dkomeza/peak/README.md

# peak
A small e-bike display meant for VESC
