dkomeza/peak/hardware/peak.step

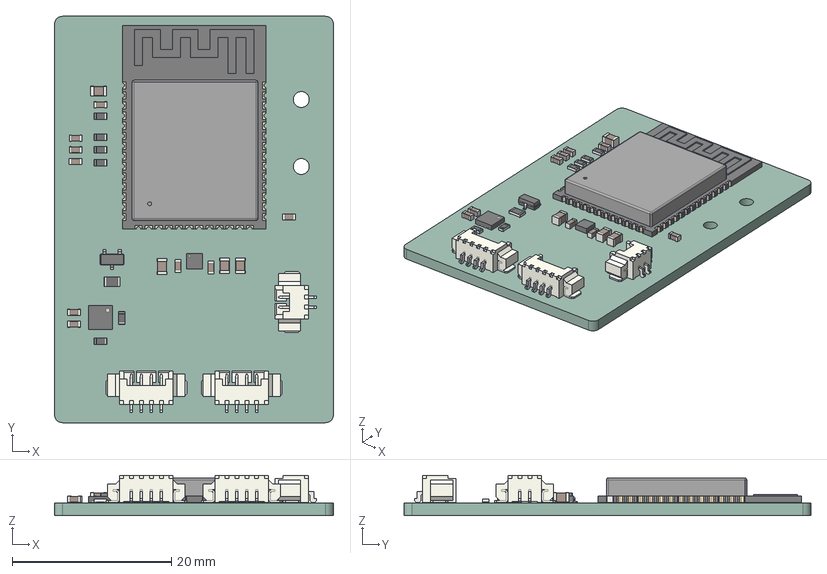
[picture p1: CAD file, 2025-06-28]
hardware/peak.step
35.0 x 51.0 x 5.05 mm
C_0603_1608Metric x 9
C_0805_2012Metric x 4
Molex_53261_0471 x 2
R_0805_2012Metric
R_0603_1608Metric x 6
SOT_23
Molex_53261_0271
ESP32-S3-WROOM-1
DFN-8-1EP_3x3mm_Pitch0.65mm
WSON_6_1EP_2x2mm_P065mm_EP1x16mm
peak_PCB
