dkomeza/peak/hardware/utils/peak-PasteTop.dxf

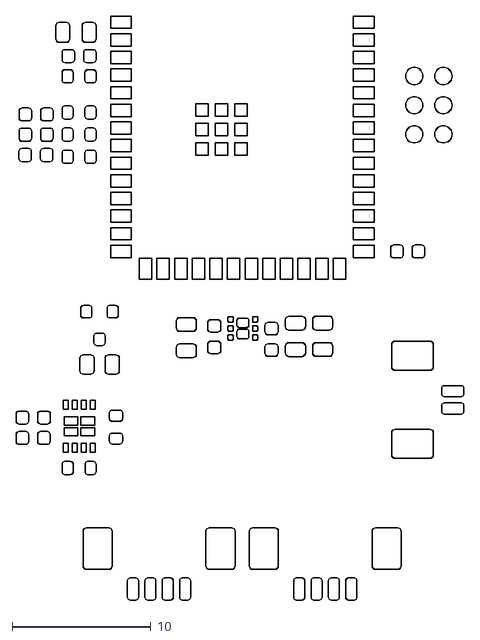
[picture p2: CAD file, 2025-04-22]
hardware/utils/peak-PasteTop.dxf
32.3 x 42.1
