dkomeza/peak/hardware/utils/peak-EdgeCuts.dxf

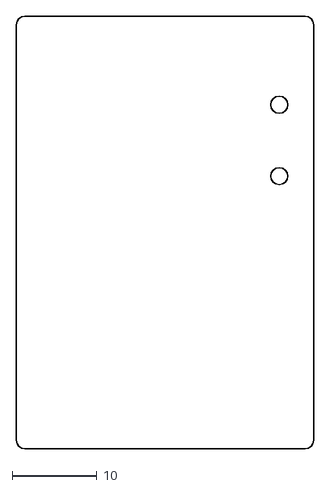
[picture p3: CAD file, 2025-04-22]
hardware/utils/peak-EdgeCuts.dxf
35.0 x 51.0
