dkomeza/peak/hardware/utils/bottomStencil.stl

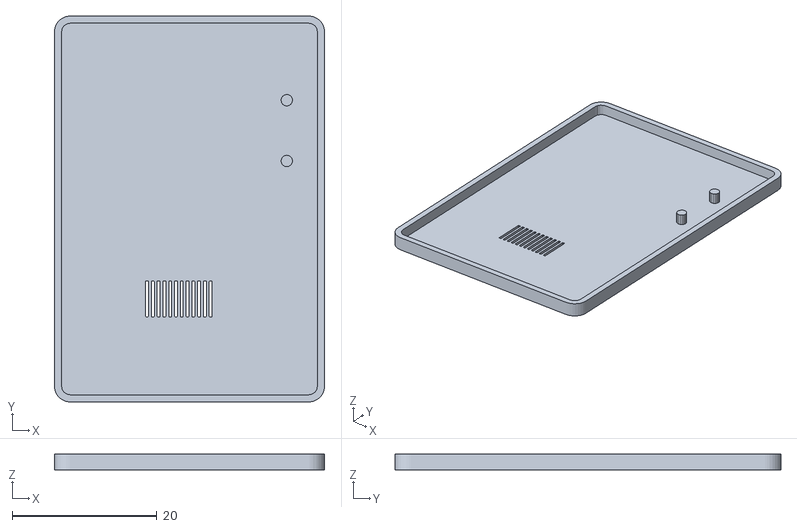
[picture p4: CAD file, 2025-04-22]
hardware/utils/bottomStencil.stl
37.4 x 53.4 x 2.20
