dkomeza/peak/hardware/utils/peak-PasteBottom.dxf

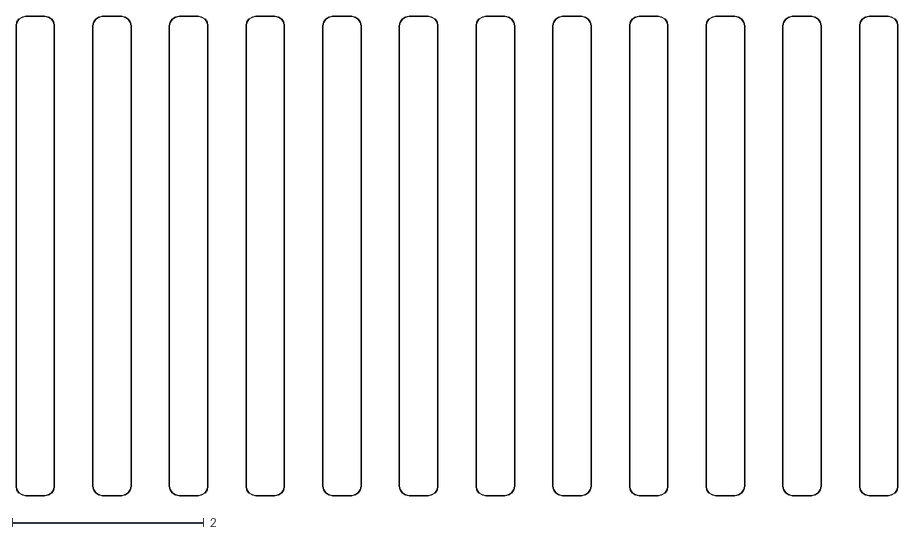
[picture p5: CAD file, 2025-04-22]
hardware/utils/peak-PasteBottom.dxf
9.20 x 5.00
