dkomeza/peak/hardware/utils/topStencil.stl

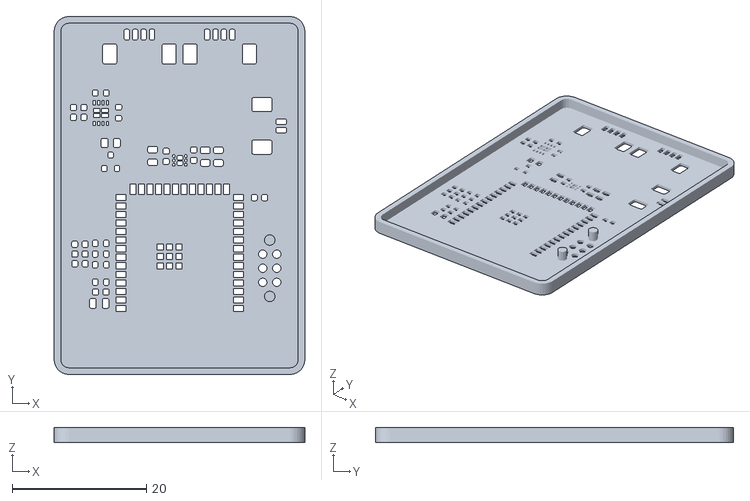
[picture p6: CAD file, 2025-04-22]
hardware/utils/topStencil.stl
37.4 x 53.4 x 2.20
