dkomeza/peak/(list of files, cad)

Other CAD files:
hardware/utils/topStencil.scad
hardware/peak.3mf
