dkomeza/peak/hardware/peak.pdf

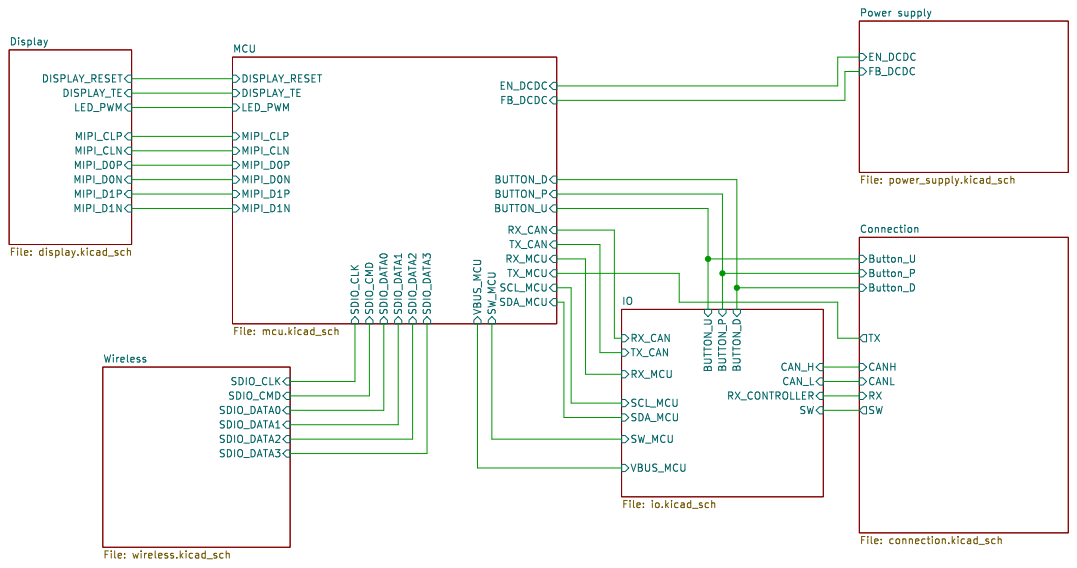
[picture p7: page 1]

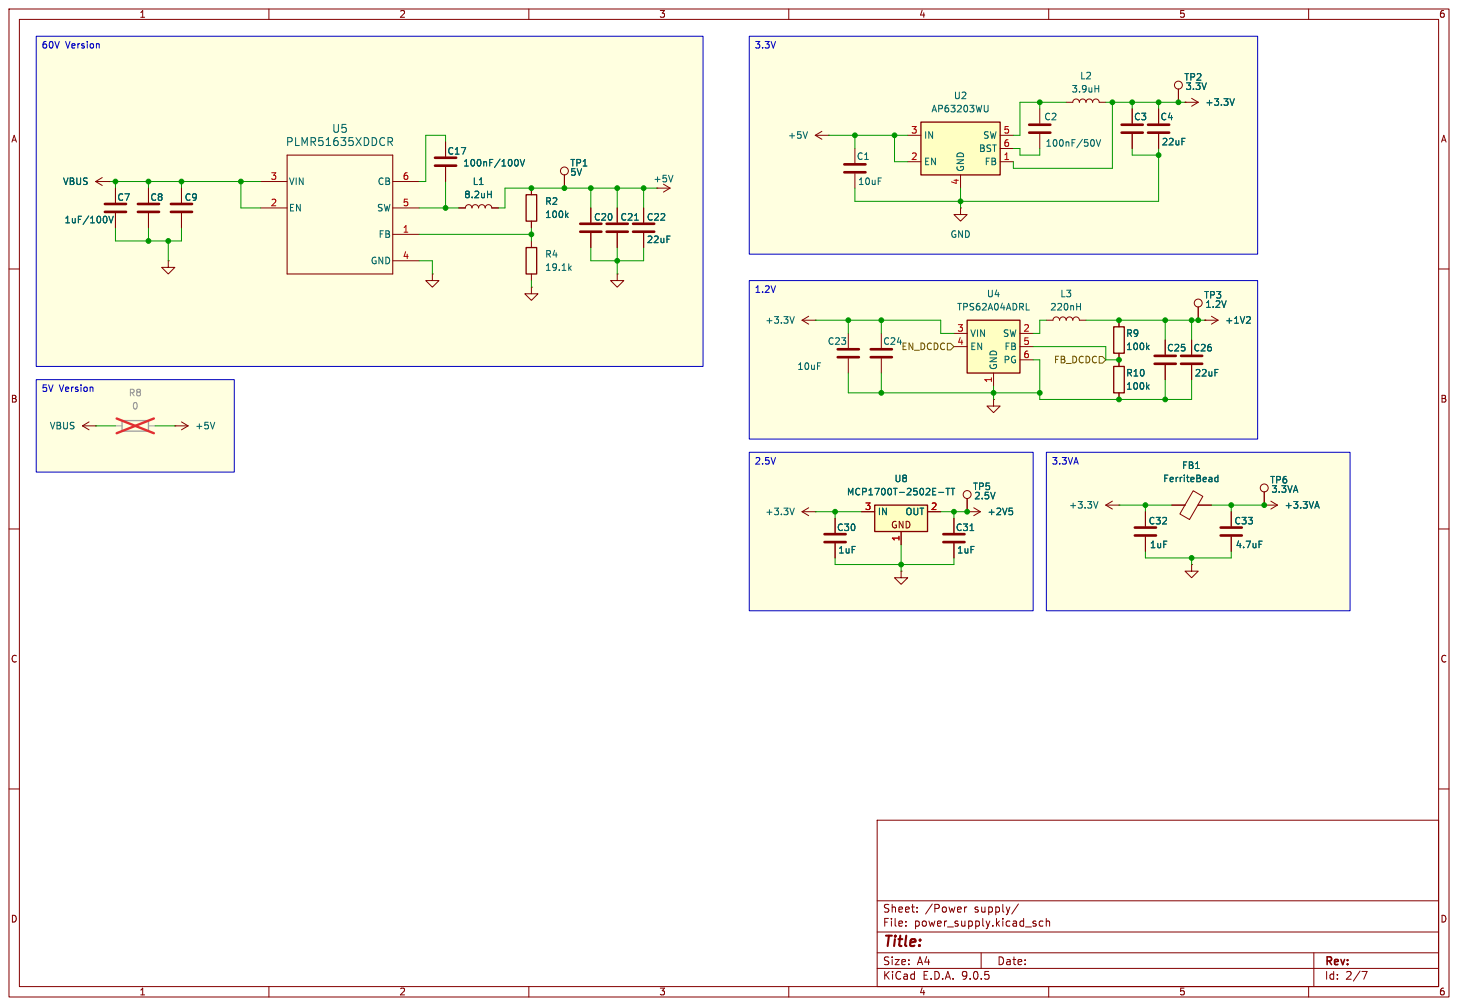
[picture p8: page 2]

1 OUT 2 U8 MCP1700T-2502E-TT C24 VIN 3 EN 4 GND

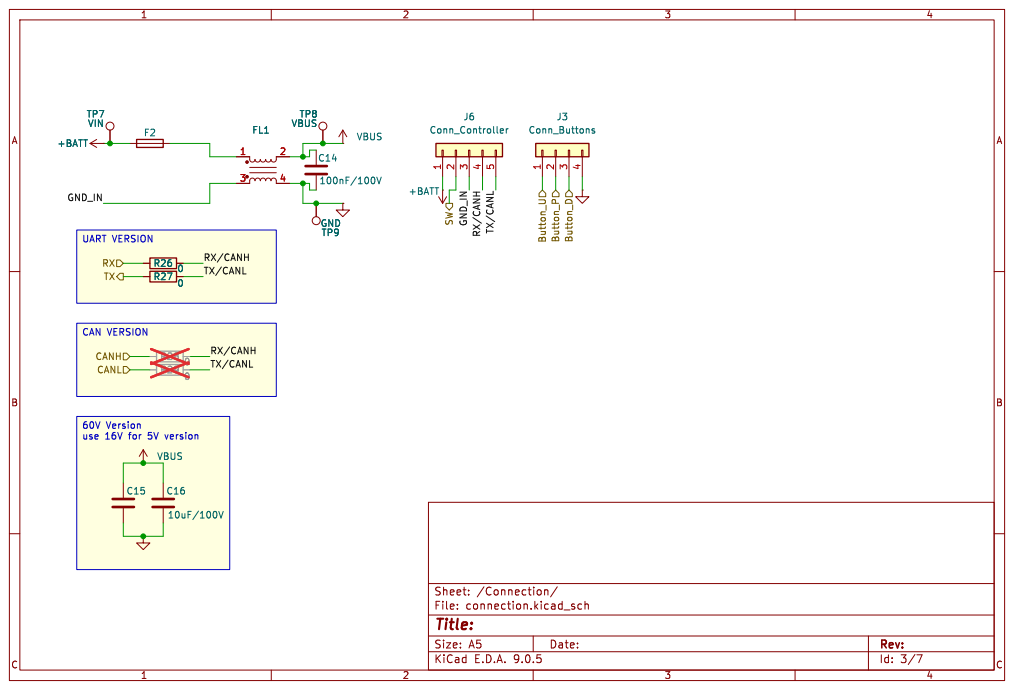
[picture p9: page 3]

use 16V for 5V version UART VERSION

Id: 3/7 Title: File: connection.kicad_sch Sheet: /Connection/ R29

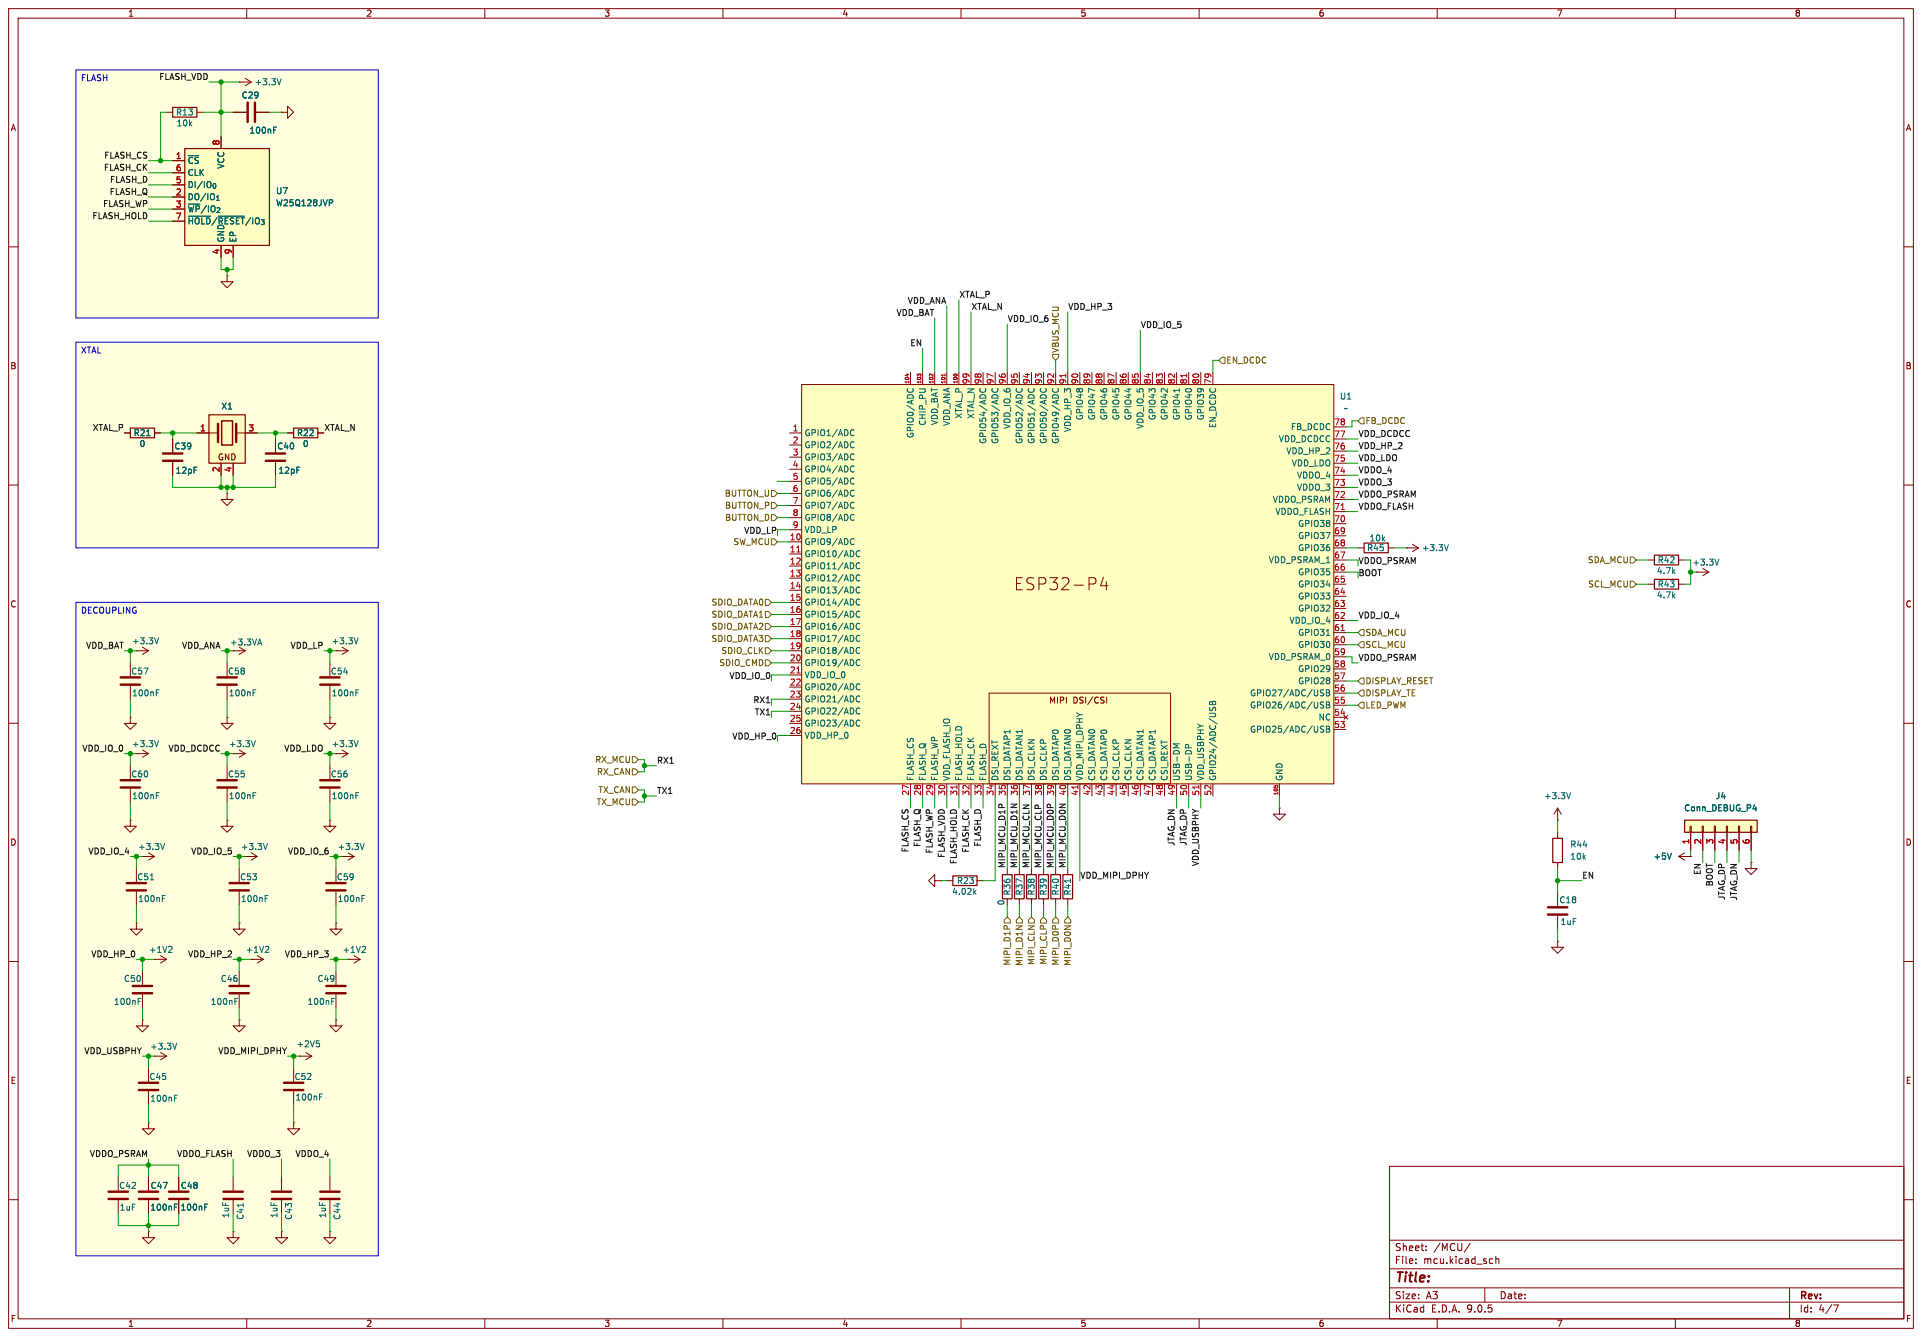
[picture p10: page 4]

Id: 4/7 Title: File: mcu.kicad_sch Sheet: /MCU/ +1V2 C51

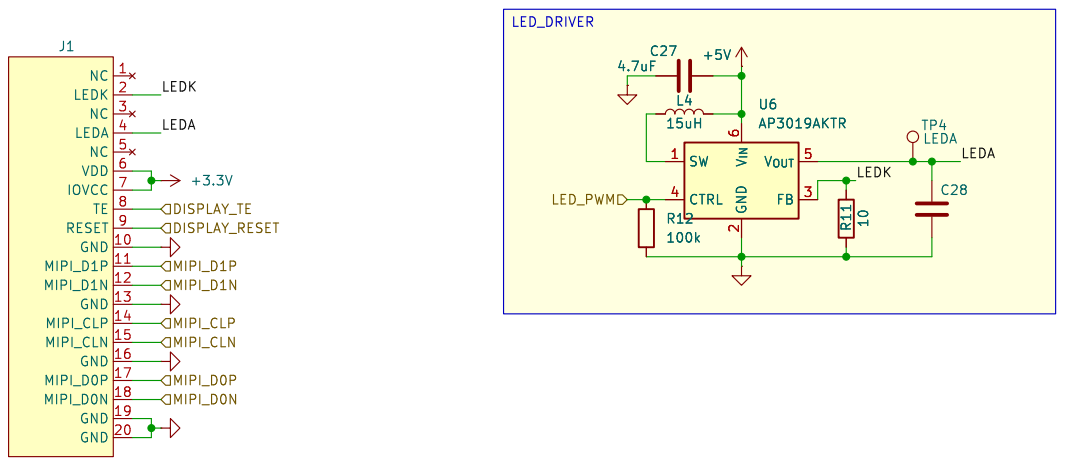
[picture p11: page 5]

Id: 5/7 Title: File: display.kicad_sch Sheet: /Display/

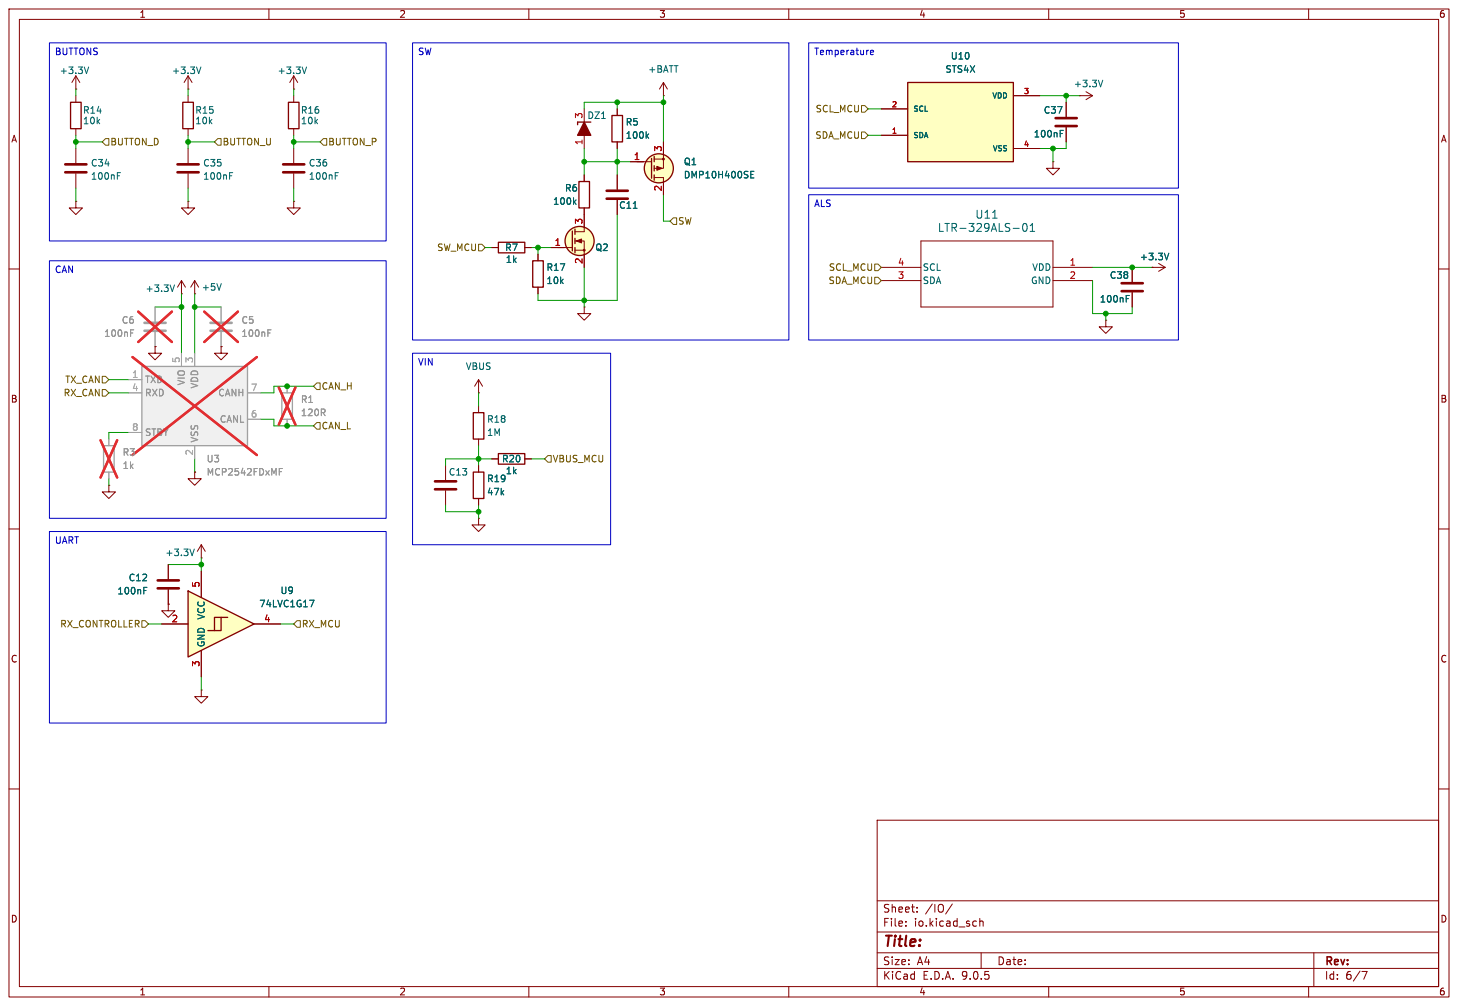
[picture p12: page 6]

Id: 6/7 Title: File: io.kicad_sch Sheet: /IO/

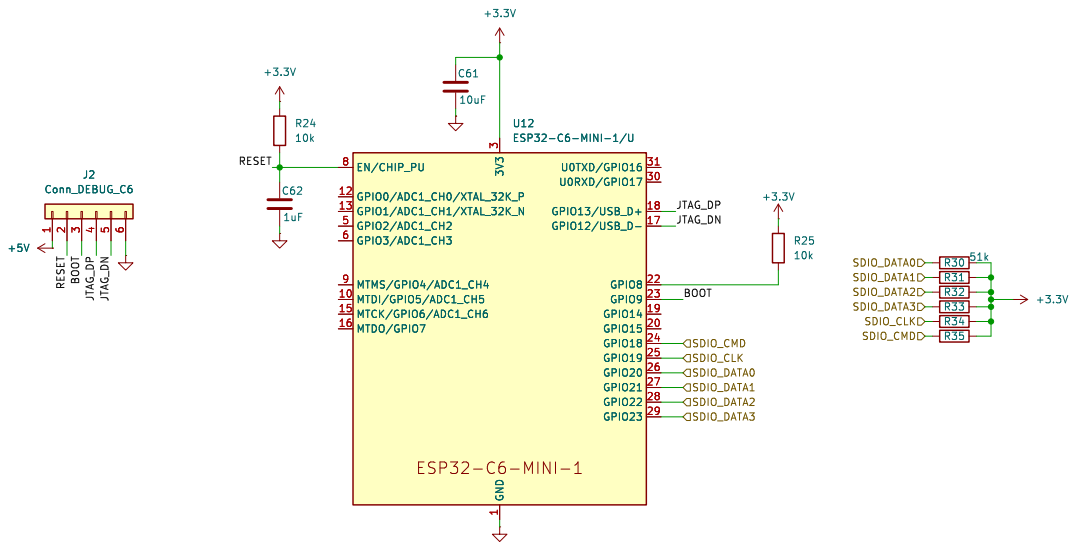
[picture p13: page 7]

Id: 7/7 Title: File: wireless.kicad_sch Sheet: /Wireless/
