dkomeza/peak/hardware/peak.kicad_pcb

## KiCad design hardware/peak.kicad_pcb (2026-03-02)

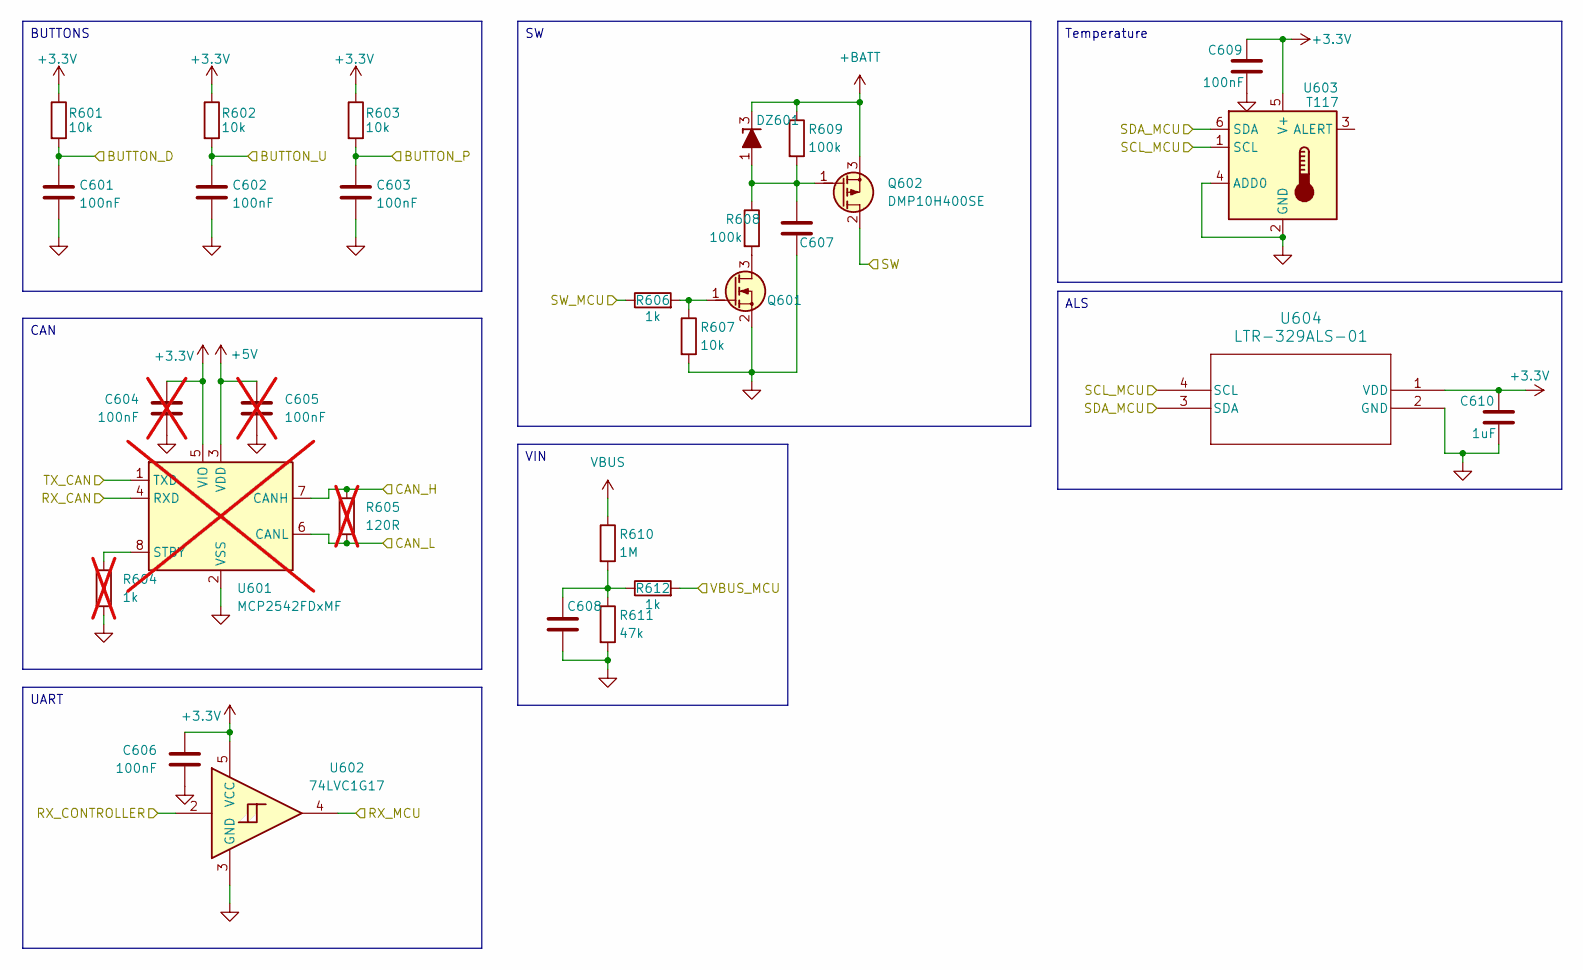
[picture p14: schematic io.kicad_sch]

Parts:
C601, C602, C603, C606, C609: 100nF; C_0603_1608Metric
C604, C605: 100nF; C_0603_1608Metric; not fitted
C607: 100nF/100V; C_0805_2012Metric
C608, C610: 1uF; C_0603_1608Metric
DZ601: BZX84-C12; SOT-23
Q601: BSS123; SOT-23
Q602: DMP10H400SE; SOT-223-3_TabPin2
R601, R602, R603, R607: 10k; R_0603_1608Metric
R604: 1k; R_0603_1608Metric; not fitted
R605: 120R; R_0603_1608Metric; not fitted
R606, R612: 1k; R_0603_1608Metric
R608, R609: 100k; R_0805_2012Metric
R610: 1M; R_0603_1608Metric
R611: 47k; R_0603_1608Metric
U601: MCP2542FDxMF; DFN-8-1EP_3x3mm_P0.65mm_EP1.55x2.4mm; not fitted
U602: 74LVC1G17; SOT-23-5
U603: T117; DFN-6-1EP_2x2mm_P0.65mm_EP1x1.6mm
U604: LTR-329ALS-01; LTR-329ALS-01_LTO

Connections:
+3.3V: C604.1, C606.1, C609.1, C610.1, R601.1, R602.1, R603.1, U601.5 (VIO), U602.5 (VCC), U603.5 (V+), U604.1 (VDD); also elsewhere on the board
+5V: C605.1, U601.3 (VDD); also elsewhere on the board
+BATT: DZ601.3 (K), Q602.3 (S), R609.1; also elsewhere on the board
/Connection/Button_D: C601.1, R601.2; also elsewhere on the board
/Connection/Button_P: C603.1, R603.2; also elsewhere on the board
/Connection/Button_U: C602.1, R602.2; also elsewhere on the board
/Connection/CANH: R605.1, U601.7 (CANH); also elsewhere on the board
/Connection/CANL: R605.2, U601.6 (CANL); also elsewhere on the board
/Connection/RX: U602.2; also elsewhere on the board
/Connection/SW: Q602.2 (D); also elsewhere on the board
/IO/SCL_MCU: U603.1 (SCL), U604.4 (SCL); also elsewhere on the board
/IO/SDA_MCU: U603.6 (SDA), U604.3 (SDA); also elsewhere on the board
/IO/SW_MCU: R606.1; also elsewhere on the board
/IO/VBUS_MCU: R612.2; also elsewhere on the board
/MCU/RX1: U601.4 (RXD), U602.4; also elsewhere on the board
/MCU/TX1: U601.1 (TXD); also elsewhere on the board
GND: C601.2, C602.2, C603.2, C604.2, C605.2, C606.2, C607.2, C608.2, C609.2, C610.2, Q601.2 (S), R604.2, R607.2, R611.2, U601.2 (VSS), U601.9 (VSS), U602.3 (GND), U603.2 (GND), U603.4 (ADD0), U604.2 (GND); also elsewhere on the board
unnamed: C608.1, R610.2, R611.1, R612.1
unnamed: C607.1, DZ601.1 (A), Q602.1 (G), R608.1, R609.2
unnamed: Q601.3 (D), R608.2
unnamed: Q601.1 (G), R606.2, R607.1
unnamed: R604.1, U601.8 (STBY)
VBUS: R610.1; also elsewhere on the board

Notes on the sheet:
Temperature
ALS
VIN
UART
BUTTONS
CAN

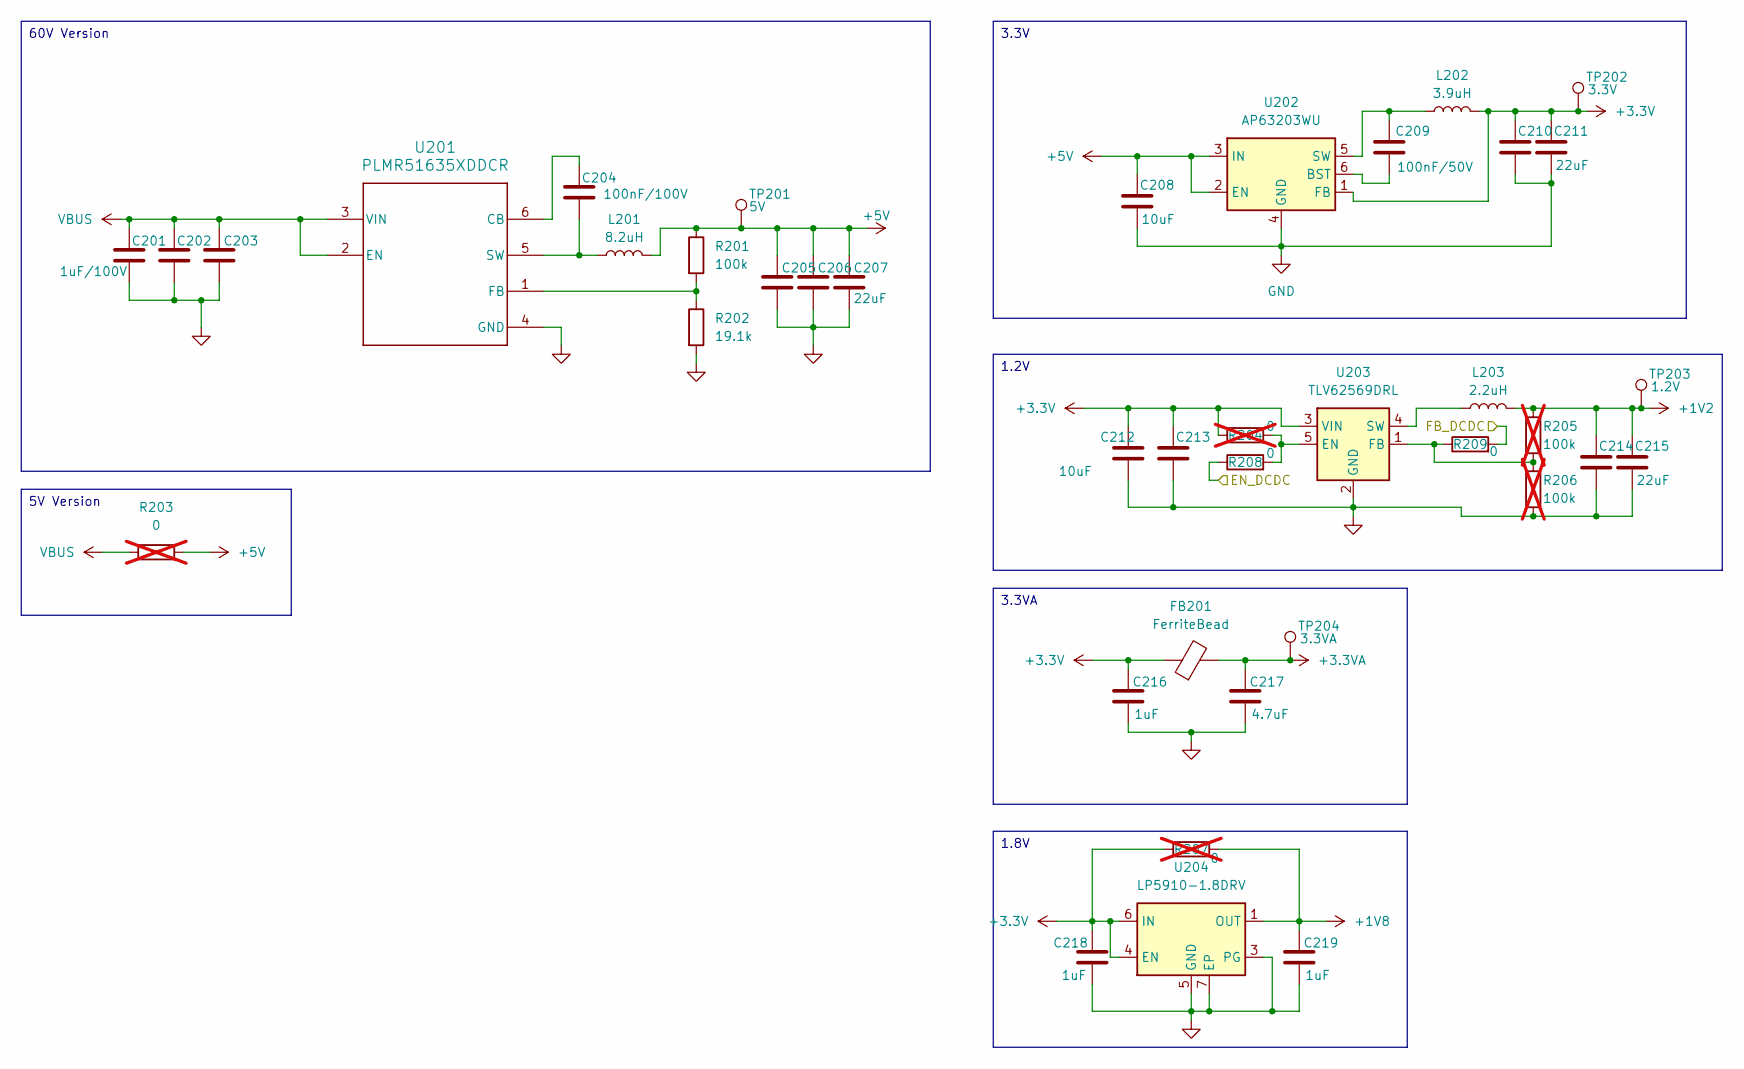
[picture p15: schematic power_supply.kicad_sch]

Parts:
C201, C202, C203: 1uF/100V; C_1206_3216Metric
C204: 100nF/100V; C_0805_2012Metric
C205, C206, C207, C210, C211, C214, C215: 22uF; C_0805_2012Metric
C208, C212: 10uF; C_0805_2012Metric
C209: 100nF/50V; C_0603_1608Metric
C213: 4.7nF; C_0603_1608Metric
C216, C218, C219: 1uF; C_0603_1608Metric
C217: 4.7uF; C_0603_1608Metric
FB201: FerriteBead; L_0805_2012Metric
L201: 8.2uH; L_Bourns_SRP5030T
L202: 3.9uH; L_APV_ANR4030
L203: 2.2uH; L_1008_2520Metric
R201: 100k; R_0603_1608Metric
R202: 19.1k; R_0603_1608Metric
R203: 0; R_0603_1608Metric; not fitted
R204, R207: 0; R_0402_1005Metric; not fitted
R205, R206: 100k; R_0402_1005Metric; not fitted
R208, R209: 0; R_0402_1005Metric
TP201: 5V; TestPoint_Pad_D1.0mm
TP202: 3.3V; TestPoint_Pad_D1.0mm
TP203: 1.2V; TestPoint_Pad_D1.0mm
TP204: 3.3VA; TestPoint_Pad_D1.0mm
U201: PLMR51635XDDCR; SOT-23-6
U202: AP63203WU; TSOT-23-6
U203: TLV62569DRL; SOT-563
U204: LP5910-1.8DRV; WSON-6-1EP_2x2mm_P0.65mm_EP1x1.6mm

Connections:
+1V2: C214.1, C215.1, L203.2, R205.1, TP203.1; also elsewhere on the board
+1V8: C219.1, R207.2, U204.1 (OUT); also elsewhere on the board
+3.3V: C210.1, C211.1, C212.1, C213.1, C216.1, C218.1, FB201.1, L202.2, R204.1, R207.1, TP202.1, U202.1 (FB), U203.3 (VIN), U204.4 (EN), U204.6 (IN); also elsewhere on the board
+3.3VA: C217.1, FB201.2, TP204.1; also elsewhere on the board
+5V: C205.1, C206.1, C207.1, C208.1, L201.2, R201.1, R203.2, TP201.1, U202.2 (EN), U202.3 (IN); also elsewhere on the board
/MCU/EN_DCDC: R208.1; also elsewhere on the board
/MCU/FB_DCDC: R209.2; also elsewhere on the board
GND: C201.2, C202.2, C203.2, C205.2, C206.2, C207.2, C208.2, C210.2, C211.2, C212.2, C213.2, C214.2, C215.2, C216.2, C217.2, C218.2, C219.2, R202.2, R206.2, U201.4 (GND), U202.4 (GND), U203.2 (GND), U204.3 (PG), U204.5 (GND), U204.7 (EP); also elsewhere on the board
unnamed: C204.1, U201.6 (CB)
unnamed: R201.2, R202.1, U201.1 (FB)
unnamed: C204.2, L201.1, U201.5 (SW)
unnamed: C209.2, U202.6 (BST)
unnamed: C209.1, L202.1, U202.5 (SW)
unnamed: R204.2, R208.2, U203.5 (EN)
unnamed: R205.2, R206.1, R209.1, U203.1 (FB)
unnamed: L203.1, U203.4 (SW)
VBUS: C201.1, C202.1, C203.1, R203.1, U201.2 (EN), U201.3 (VIN); also elsewhere on the board

Notes on the sheet:
3.3VA
3.3V
5V Version
60V Version
1.8V
1.2V

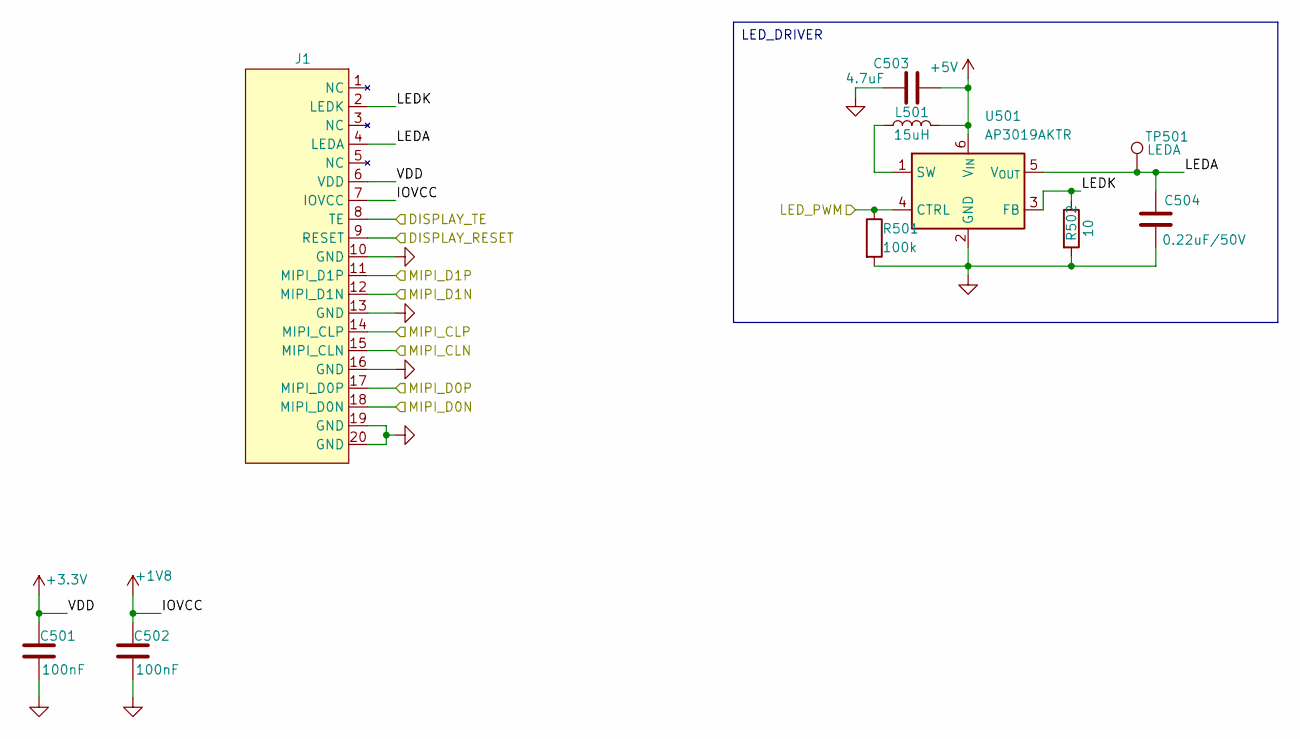
[picture p16: schematic display.kicad_sch]

Parts:
C501, C502: 100nF; C_0402_1005Metric
C503: 4.7uF; C_0603_1608Metric
C504: 0.22uF/50V; C_0805_2012Metric
J1: 5034802000
L501: 15uH; L_1210_3225Metric
R501: 100k; R_0603_1608Metric
R502: 10; R_0805_2012Metric
TP501: LEDA; TestPoint_Pad_D1.0mm
U501: AP3019AKTR; SOT-23-6

Connections:
+1V8: C502.1, J1.7 (IOVCC); also elsewhere on the board
+3.3V: C501.1, J1.6 (VDD); also elsewhere on the board
+5V: C503.2, L501.2, U501.6 (V_{IN}); also elsewhere on the board
/Display/DISPLAY_RESET: J1.9 (RESET); also elsewhere on the board
/Display/DISPLAY_TE: J1.8 (TE); also elsewhere on the board
/Display/LEDA: C504.1, J1.4 (LEDA), TP501.1, U501.5 (V_{OUT})
/Display/LEDK: J1.2 (LEDK), R502.1, U501.3 (FB)
/Display/LED_PWM: R501.1, U501.4 (CTRL); also elsewhere on the board
/Display/MIPI_CLN: J1.15 (MIPI_CLN); also elsewhere on the board
/Display/MIPI_CLP: J1.14 (MIPI_CLP); also elsewhere on the board
/Display/MIPI_D0N: J1.18 (MIPI_D0N); also elsewhere on the board
/Display/MIPI_D0P: J1.17 (MIPI_D0P); also elsewhere on the board
/Display/MIPI_D1N: J1.12 (MIPI_D1N); also elsewhere on the board
/Display/MIPI_D1P: J1.11 (MIPI_D1P); also elsewhere on the board
GND: C501.2, C502.2, C503.1, C504.2, J1.10 (GND), J1.13 (GND), J1.16 (GND), J1.19 (GND), J1.20 (GND), R501.2, R502.2, U501.2 (GND); also elsewhere on the board
unnamed: L501.1, U501.1 (SW)

Notes on the sheet:
LED_DRIVER

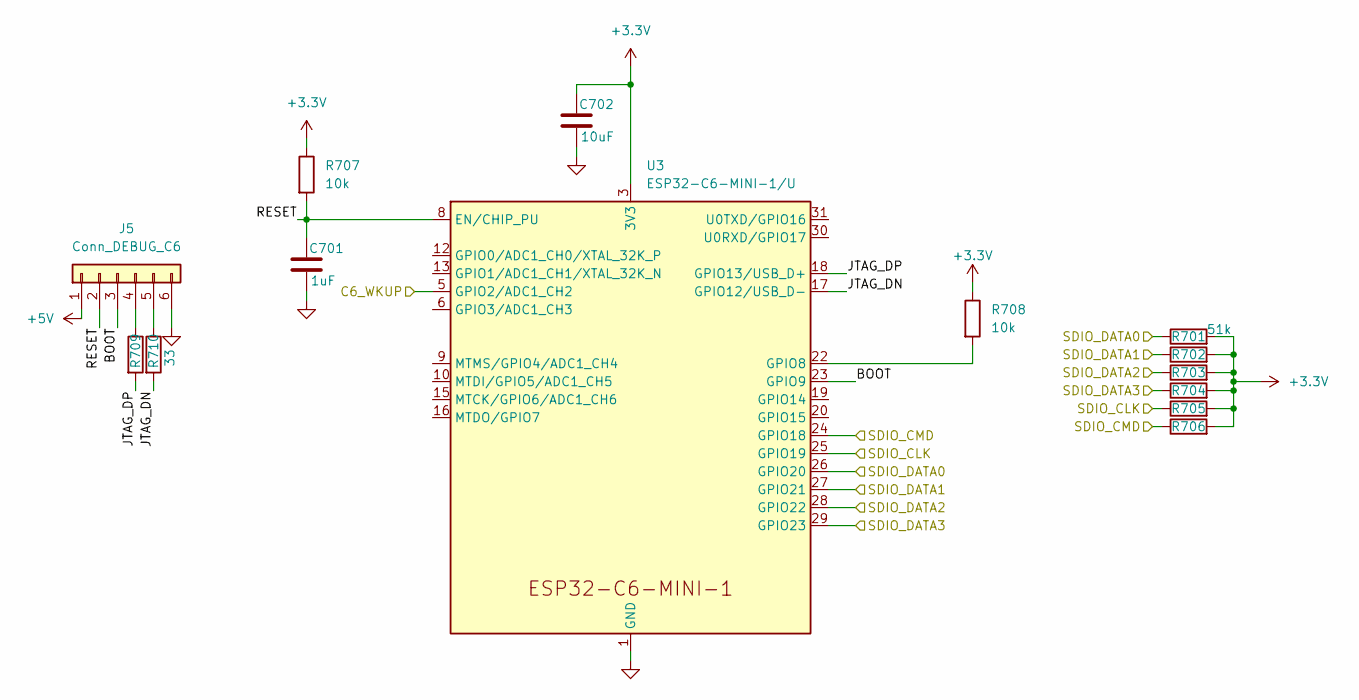
[picture p17: schematic wireless.kicad_sch]

Parts:
C701: 1uF; C_0603_1608Metric
C702: 10uF; C_0603_1608Metric
J5: Conn_DEBUG_C6; JST_SHL_SM06B-SHLS-TF_1x06-1MP_P1.00mm_Horizontal
R701, R702, R703, R704, R705, R706: 51k; R_0603_1608Metric
R707, R708: 10k; R_0603_1608Metric
R709, R710: 33; R_0402_1005Metric
U3: ESP32-C6-MINI-1/U; ESP32-C6-MINI-1

Connections:
+3.3V: C702.1, R701.2, R702.2, R703.2, R704.2, R705.2, R706.2, R707.1, R708.1, U3.3 (3V3); also elsewhere on the board
+5V: J5.1; also elsewhere on the board
/MCU/C6_WKUP: U3.5 (GPIO2/ADC1_CH2); also elsewhere on the board
/MCU/SDIO_CLK: R705.1, U3.25 (GPIO19); also elsewhere on the board
/MCU/SDIO_CMD: R706.1, U3.24 (GPIO18); also elsewhere on the board
/MCU/SDIO_DATA0: R701.1, U3.26 (GPIO20); also elsewhere on the board
/MCU/SDIO_DATA1: R702.1, U3.27 (GPIO21); also elsewhere on the board
/MCU/SDIO_DATA2: R703.1, U3.28 (GPIO22); also elsewhere on the board
/MCU/SDIO_DATA3: R704.1, U3.29 (GPIO23); also elsewhere on the board
/Wireless/BOOT: J5.3, U3.23 (GPIO9)
/Wireless/JTAG_DN: R710.2, U3.17 (GPIO12/USB_D-)
/Wireless/JTAG_DP: R709.2, U3.18 (GPIO13/USB_D+)
/Wireless/RESET: C701.1, J5.2, R707.2, U3.8 (EN/CHIP_PU)
GND: C701.2, C702.2, J5.6, U3.1 (GND), U3.2 (GND), U3.11 (GND), U3.14 (GND), U3.36 (GND), U3.37 (GND), U3.38 (GND), U3.39 (GND), U3.40 (GND), U3.41 (GND), U3.42 (GND), U3.43 (GND), U3.44 (GND), U3.45 (GND), U3.46 (GND), U3.47 (GND), U3.48 (GND), U3.49 (GND), U3.50 (GND), U3.51 (GND), U3.52 (GND), U3.53 (GND); also elsewhere on the board
unnamed: J5.4, R709.1
unnamed: J5.5, R710.1
unnamed: R708.2, U3.22 (GPIO8)

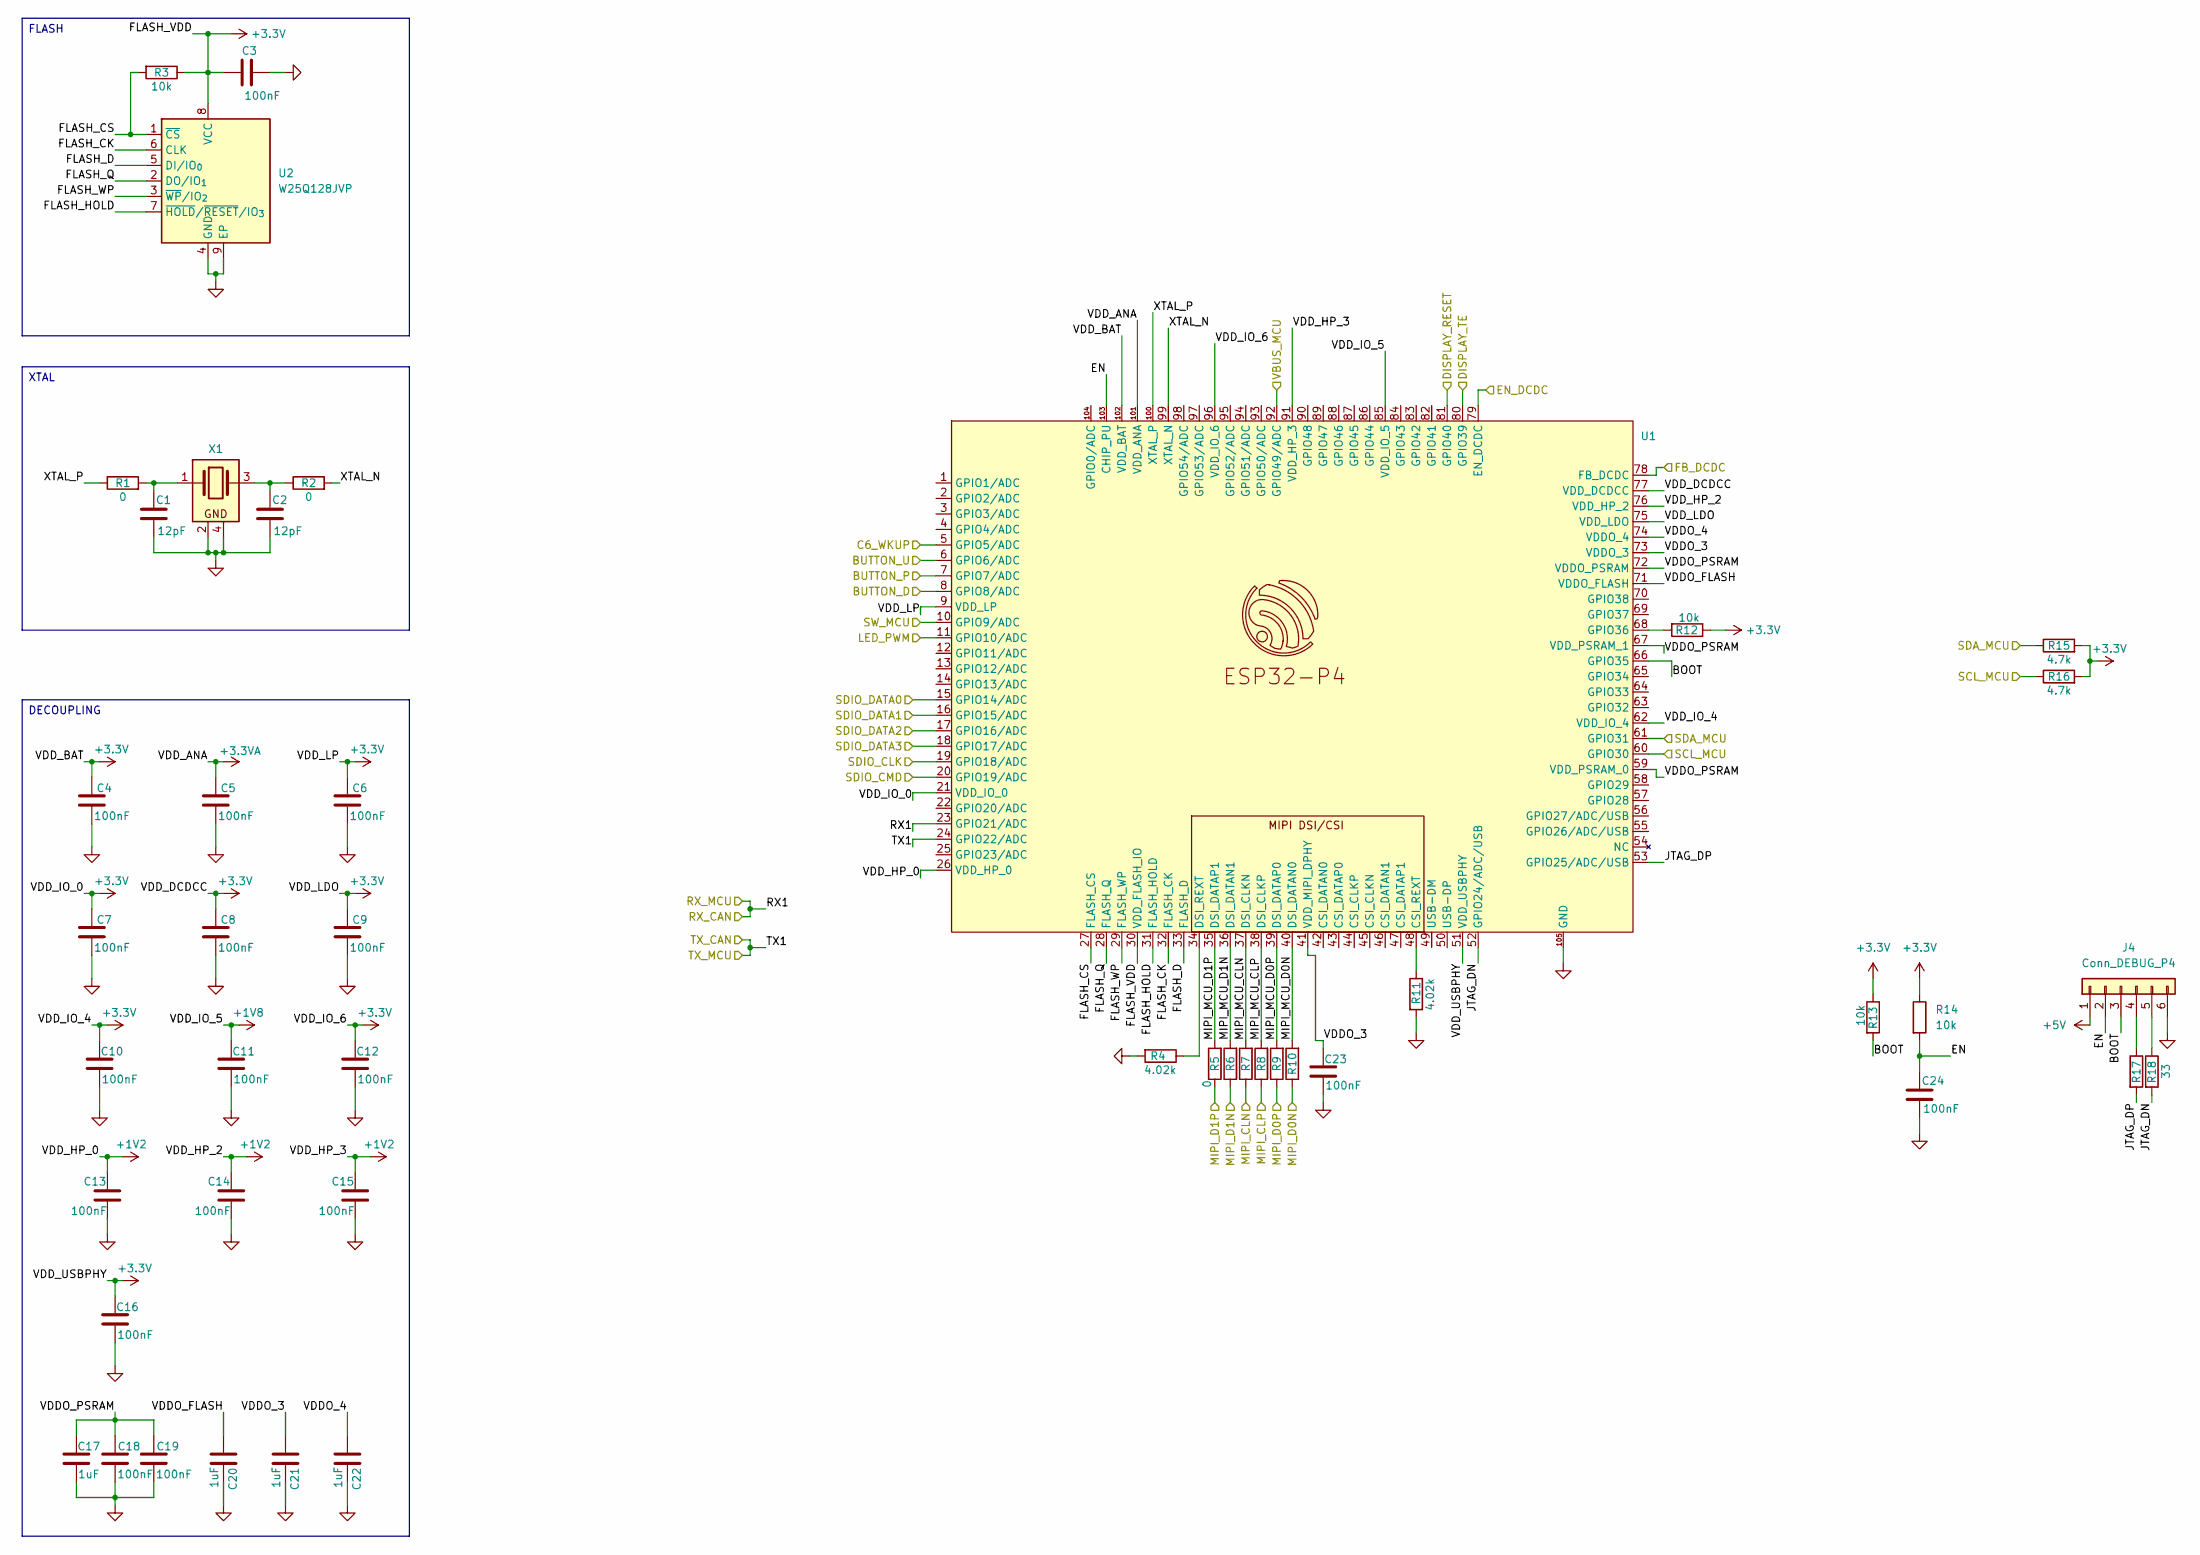
[picture p18: schematic mcu.kicad_sch]

Parts:
C1, C2: 12pF; C_0402_1005Metric
C3, C4, C5, C6, C7, C8, C9, C10, C11, C12, C13, C14, C15, C16, C18, C19, C23, C24: 100nF; C_0402_1005Metric
C17, C20, C21, C22: 1uF; C_0402_1005Metric
J4: Conn_DEBUG_P4; JST_SHL_SM06B-SHLS-TF_1x06-1MP_P1.00mm_Horizontal
R1, R2, R5, R6, R7, R8, R9, R10: 0; R_0402_1005Metric
R3, R12, R13, R14: 10k; R_0402_1005Metric
R4, R11: 4.02k; R_0402_1005Metric
R15, R16: 4.7k; R_0402_1005Metric
R17, R18: 33; R_0402_1005Metric
U1: ESP32-P4
U2: W25Q128JVP; WSON-8-1EP_6x5mm_P1.27mm_EP3.4x4.3mm
X1: ECS-400-10-37B2-CKY-TR; Crystal_SMD_2016-4Pin_2.0x1.6mm

Connections:
+1V2: C13.1, C14.1, C15.1, U1.26 (VDD_HP_0), U1.76 (VDD_HP_2), U1.91 (VDD_HP_3); also elsewhere on the board
+1V8: C11.1, U1.85 (VDD_IO_5); also elsewhere on the board
+3.3V: C3.1, C4.1, C6.1, C7.1, C8.1, C9.1, C10.1, C12.1, C16.1, R3.1, R12.1, R13.1, R14.1, R15.2, R16.2, U1.9 (VDD_LP), U1.21 (VDD_IO_0), U1.30 (VDD_FLASH_IO), U1.51 (VDD_USBPHY), U1.62 (VDD_IO_4), U1.75 (VDD_LDO), U1.77 (VDD_DCDCC), U1.96 (VDD_IO_6), U1.102 (VDD_BAT), U2.8 (VCC); also elsewhere on the board
+3.3VA: C5.1, U1.101 (VDD_ANA); also elsewhere on the board
+5V: J4.1; also elsewhere on the board
/Connection/Button_D: U1.8 (GPIO8/ADC); also elsewhere on the board
/Connection/Button_P: U1.7 (GPIO7/ADC); also elsewhere on the board
/Connection/Button_U: U1.6 (GPIO6/ADC); also elsewhere on the board
/Display/DISPLAY_RESET: U1.81 (GPIO40); also elsewhere on the board
/Display/DISPLAY_TE: U1.80 (GPIO39); also elsewhere on the board
/Display/LED_PWM: U1.11 (GPIO10/ADC); also elsewhere on the board
/Display/MIPI_CLN: R7.1; also elsewhere on the board
/Display/MIPI_CLP: R8.1; also elsewhere on the board
/Display/MIPI_D0N: R10.1; also elsewhere on the board
/Display/MIPI_D0P: R9.1; also elsewhere on the board
/Display/MIPI_D1N: R6.1; also elsewhere on the board
/Display/MIPI_D1P: R5.1; also elsewhere on the board
/IO/SCL_MCU: R16.1, U1.60 (GPIO30); also elsewhere on the board
/IO/SDA_MCU: R15.1, U1.61 (GPIO31); also elsewhere on the board
/IO/SW_MCU: U1.10 (GPIO9/ADC); also elsewhere on the board
/IO/VBUS_MCU: U1.92 (GPIO49/ADC); also elsewhere on the board
/MCU/BOOT: J4.3, R13.2, U1.66 (GPIO35)
/MCU/C6_WKUP: U1.5 (GPIO5/ADC); also elsewhere on the board
/MCU/EN: C24.1, J4.2, R14.2, U1.103 (CHIP_PU)
/MCU/EN_DCDC: U1.79 (EN_DCDC); also elsewhere on the board
/MCU/FB_DCDC: U1.78 (FB_DCDC); also elsewhere on the board
/MCU/FLASH_CK: U1.32 (FLASH_CK), U2.6 (CLK)
/MCU/FLASH_CS: R3.2, U1.27 (FLASH_CS), U2.1 (~CS)
/MCU/FLASH_D: U1.33 (FLASH_D), U2.5 (DI/IO_{0})
/MCU/FLASH_HOLD: U1.31 (FLASH_HOLD), U2.7 (~HOLD/~RESET/IO_{3})
/MCU/FLASH_Q: U1.28 (FLASH_Q), U2.2 (DO/IO_{1})
/MCU/FLASH_WP: U1.29 (FLASH_WP), U2.3 (~WP/IO_{2})
/MCU/JTAG_DN: R18.2, U1.52 (GPIO24/ADC/USB)
/MCU/JTAG_DP: R17.2, U1.53 (GPIO25/ADC/USB)
/MCU/MIPI_MCU_CLN: R7.2, U1.37 (DSI_CLKN)
/MCU/MIPI_MCU_CLP: R8.2, U1.38 (DSI_CLKP)
/MCU/MIPI_MCU_D0N: R10.2, U1.40 (DSI_DATAN0)
/MCU/MIPI_MCU_D0P: R9.2, U1.39 (DSI_DATAP0)
/MCU/MIPI_MCU_D1N: R6.2, U1.36 (DSI_DATAN1)
/MCU/MIPI_MCU_D1P: R5.2, U1.35 (DSI_DATAP1)
/MCU/RX1: U1.23 (GPIO21/ADC); also elsewhere on the board
/MCU/SDIO_CLK: U1.19 (GPIO18/ADC); also elsewhere on the board
/MCU/SDIO_CMD: U1.20 (GPIO19/ADC); also elsewhere on the board
/MCU/SDIO_DATA0: U1.15 (GPIO14/ADC); also elsewhere on the board
/MCU/SDIO_DATA1: U1.16 (GPIO15/ADC); also elsewhere on the board
/MCU/SDIO_DATA2: U1.17 (GPIO16/ADC); also elsewhere on the board
/MCU/SDIO_DATA3: U1.18 (GPIO17/ADC); also elsewhere on the board
/MCU/TX1: U1.24 (GPIO22/ADC); also elsewhere on the board
/MCU/VDDO_3: C21.1, C23.1, U1.41 (VDD_MIPI_DPHY), U1.73 (VDDO_3)
/MCU/VDDO_4: C22.1, U1.74 (VDDO_4)
/MCU/VDDO_FLASH: C20.1, U1.71 (VDDO_FLASH)
/MCU/VDDO_PSRAM: C17.1, C18.1, C19.1, U1.59 (VDD_PSRAM_0), U1.67 (VDD_PSRAM_1), U1.72 (VDDO_PSRAM)
/MCU/XTAL_N: R2.2, U1.99 (XTAL_N)
/MCU/XTAL_P: R1.1, U1.100 (XTAL_P)
GND: C1.2, C2.2, C3.2, C4.2, C5.2, C6.2, C7.2, C8.2, C9.2, C10.2, C11.2, C12.2, C13.2, C14.2, C15.2, C16.2, C17.2, C18.2, C19.2, C20.2, C21.2, C22.2, C23.2, C24.2, J4.6, R4.2, R11.2, U1.105 (GND), U2.4 (GND), U2.9 (EP), X1.2, X1.4; also elsewhere on the board
unnamed: C1.1, R1.2, X1.1
unnamed: C2.1, R2.1, X1.3
unnamed: J4.4, R17.1
unnamed: J4.5, R18.1
unnamed: R11.1, U1.48 (CSI_REXT)
unnamed: R4.1, U1.34 (DSI_REXT)
unnamed: R12.2, U1.68 (GPIO36)

Notes on the sheet:
XTAL
FLASH
DECOUPLING

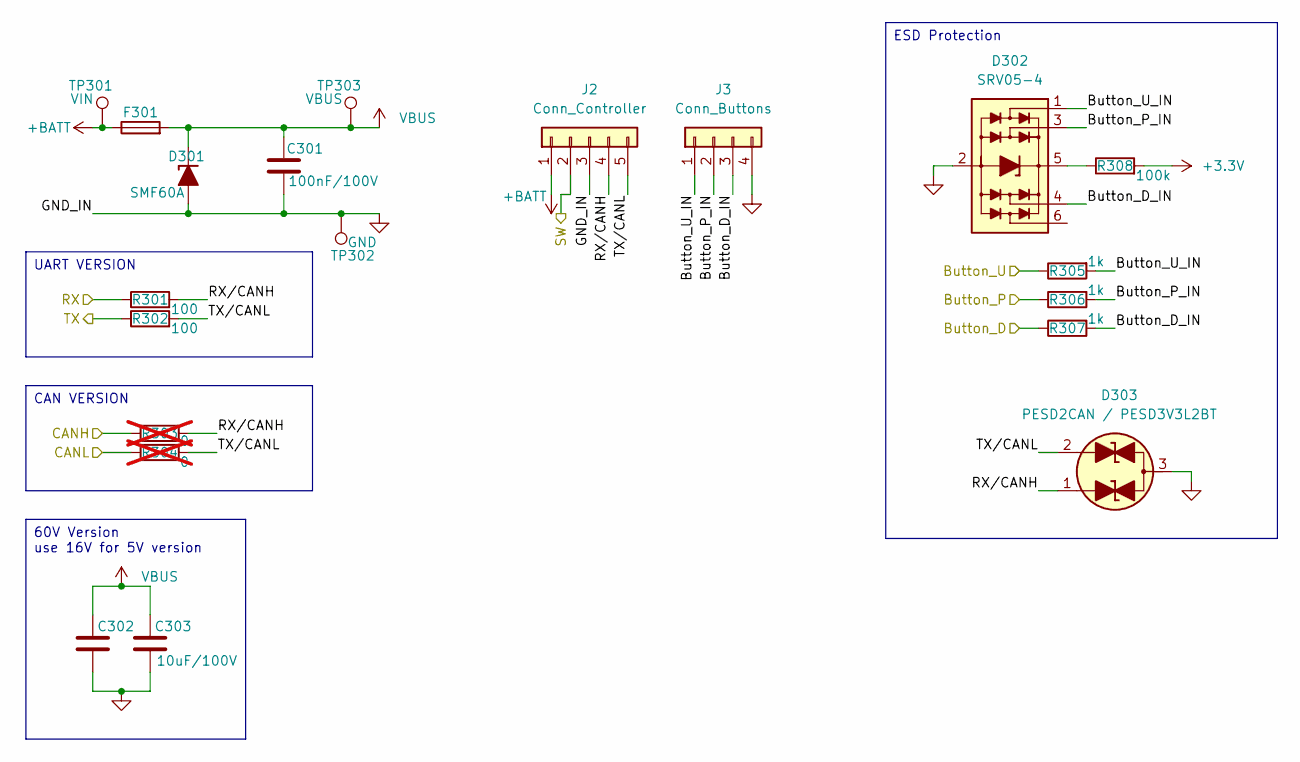
[picture p19: schematic connection.kicad_sch]

Parts:
C301: 100nF/100V; C_0805_2012Metric
C302, C303: 10uF/100V; C_1206_3216Metric
D301: SMF60A; D_SOD-123F
D302: SRV05-4; SOT-23-6
D303: PESD2CAN / PESD3V3L2BT; SOT-23
F301: Fuse; Fuse_1206_3216Metric
J2: Conn_Controller; Molex_PicoBlade_53261-0571_1x05-1MP_P1.25mm_Horizontal
J3: Conn_Buttons; Molex_PicoBlade_53261-0471_1x04-1MP_P1.25mm_Horizontal
R301, R302: 100; R_0603_1608Metric
R303, R304: 0; R_0603_1608Metric; not fitted
R305, R306, R307: 1k; R_0603_1608Metric
R308: 100k; R_0603_1608Metric
TP301: VIN; TestPoint_Pad_D1.0mm
TP302: GND; TestPoint_Pad_D1.0mm
TP303: VBUS; TestPoint_Pad_D1.0mm

Connections:
+3.3V: R308.2; also elsewhere on the board
+BATT: F301.1, J2.1, TP301.1; also elsewhere on the board
/Connection/Button_D: R307.1; also elsewhere on the board
/Connection/Button_D_IN: D302.4 (L3), J3.3, R307.2
/Connection/Button_P: R306.1; also elsewhere on the board
/Connection/Button_P_IN: D302.3 (L2), J3.2, R306.2
/Connection/Button_U: R305.1; also elsewhere on the board
/Connection/Button_U_IN: D302.1 (L1), J3.1, R305.2
/Connection/CANH: R303.1; also elsewhere on the board
/Connection/CANL: R304.1; also elsewhere on the board
/Connection/RX: R301.1; also elsewhere on the board
/Connection/RX/CANH: D303.1 (A1), J2.4, R301.2, R303.2
/Connection/SW: J2.2; also elsewhere on the board
/Connection/TX/CANL: D303.2 (A2), J2.5, R302.2, R304.2
/MCU/TX1: R302.1; also elsewhere on the board
GND: C301.2, C302.2, C303.2, D301.2 (A), D302.2 (VN), D303.3 (Com), J2.3, J3.4, TP302.1; also elsewhere on the board
unnamed: D302.5 (VP), R308.1
VBUS: C301.1, C302.1, C303.1, D301.1 (K), F301.2, TP303.1; also elsewhere on the board

Notes on the sheet:
CAN VERSION
ESD Protection
60V Version use 16V for 5V version
UART VERSION

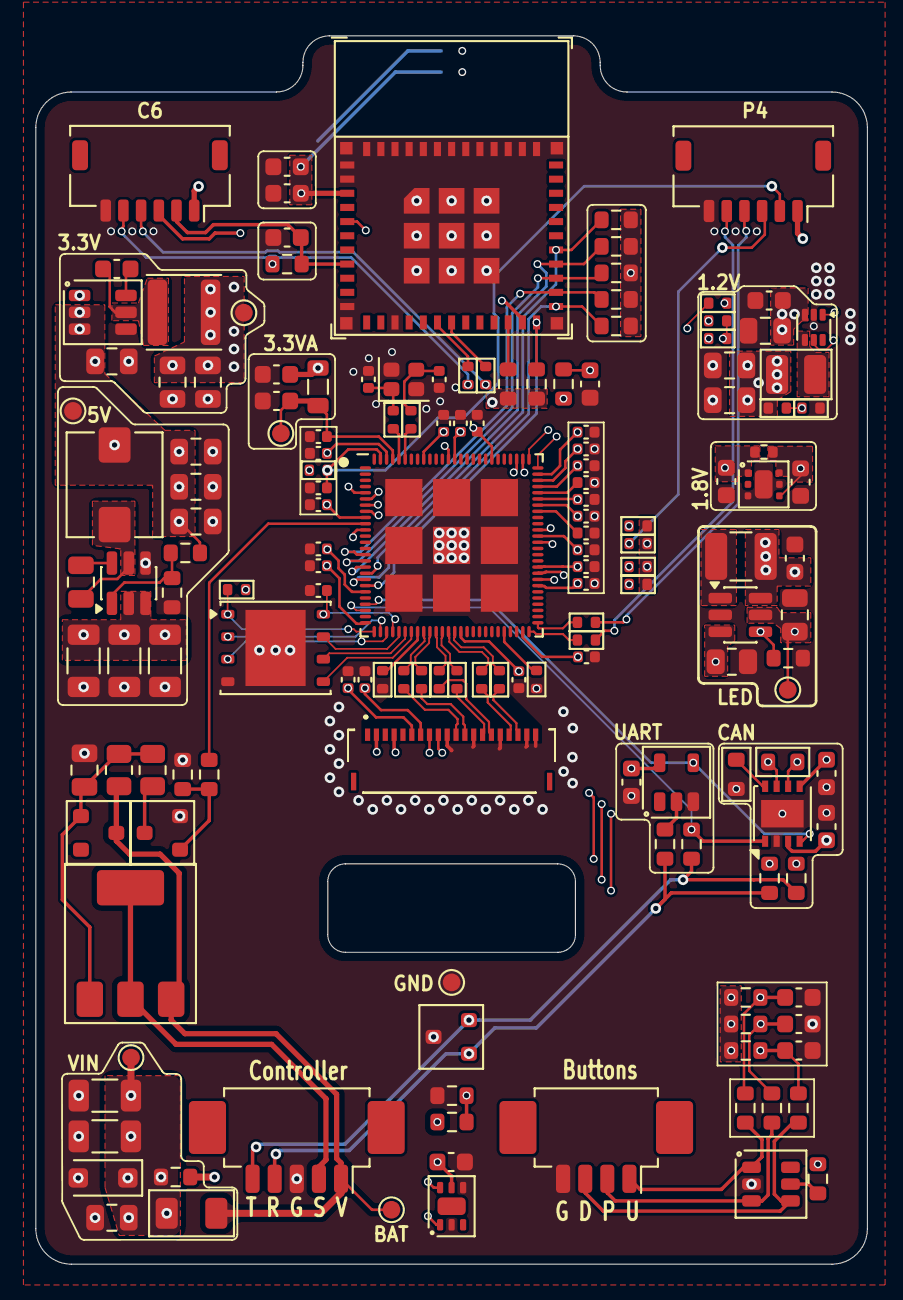
[picture p20: board peak.kicad_pcb from above]

Board: 6 copper layers, 47.0 x 69.4 mm, 158 parts (1 on the bottom side), 97 nets.
