dkomeza/peak/software/main/main.c

#include "display/display.h"
#include "esp_log.h"
#include "freertos/FreeRTOS.h"
#include "freertos/idf_additions.h"
#include "freertos/queue.h"
#include "freertos/task.h"
#include <esp_attr.h>
#include <esp_err.h>
#include <esp_heap_caps.h>
#include <esp_system.h>
#include <esp_task.h>
#include <esp_timer.h>
#include <inttypes.h>
#include <nvs_flash.h>
#include <stdbool.h>

#include "boot/boot.h"
#include "buttons.h"
#include "display_adapter.h"
#include "driver/i2c_master.h"
#include "esc/esc.h"
#include "power.h"

#include "display/display.h"

#include "io/battery.h"
#include "io/ltr329.h"
#include "io/t117.h"

#include "peak_ble/peak_ble.h"
#include "vesc/vesc_bridge.h"

#define PEAK_APP_TASK_STACK_SIZE 8192

static const char *TAG = "peak_app";
static i2c_master_bus_handle_t bus_handle;
static volatile bool s_esc_ready;
static volatile bool s_mountain_requested;

void i2c_master_init() {
  i2c_master_bus_config_t bus_config = {.sda_io_num = 31,
                                        .scl_io_num = 30,
                                        .clk_source = I2C_CLK_SRC_DEFAULT,
                                        .flags = {
                                            .enable_internal_pullup = false,
                                        }};
  ESP_ERROR_CHECK(i2c_new_master_bus(&bus_config, &bus_handle));
}

static void handle_button_power_long(void) {
  ESP_LOGI(TAG, "POWER long press: disabling controller and sleeping display");
  if (s_esc_ready) {
    esp_err_t ret = esc_set_controller_enabled(false);
    if (ret != ESP_OK) {
      ESP_LOGW(TAG, "failed to disable controller: %s", esp_err_to_name(ret));
    }
  }
  display_sleep();
}

static void handle_button_power_long_stop(void) {
  ESP_LOGI(TAG, "POWER long press released");
  power_enter_deep_sleep();
}

static void handle_gear_up(void) {
  esp_err_t ret = esc_gear_up();
  if (ret != ESP_OK) {
    ESP_LOGW(TAG, "failed to increase gear: %s", esp_err_to_name(ret));
  }
}

static void handle_gear_down(void) {
  esp_err_t ret = esc_gear_down();
  if (ret != ESP_OK) {
    ESP_LOGW(TAG, "failed to decrease gear: %s", esp_err_to_name(ret));
  }
}

static void handle_support_mode_toggle(void) {
  esc_state_t state;
  esc_get_state(&state);
  if ((state.valid_fields & ESC_STATE_SUPPORT_MODE) == 0) {
    ESP_LOGW(TAG, "cannot switch support mode before ESC state is available");
    return;
  }

  esc_support_mode_t next_mode;
  switch (state.support_mode) {
  case ESC_SUPPORT_MODE_PAS:
    next_mode = ESC_SUPPORT_MODE_TORQUE;
    break;
  case ESC_SUPPORT_MODE_TORQUE:
    next_mode = ESC_SUPPORT_MODE_PAS;
    break;
  default:
    ESP_LOGW(TAG, "cannot switch unknown support mode: %d",
             state.support_mode);
    return;
  }

  esp_err_t ret = esc_set_support_mode(next_mode);
  if (ret != ESP_OK) {
    ESP_LOGW(TAG, "failed to switch support mode: %s", esp_err_to_name(ret));
    return;
  }

  ESP_LOGI(TAG, "switching support mode to %s",
           next_mode == ESC_SUPPORT_MODE_TORQUE ? "TORQUE" : "PAS");
}

static void handle_boot_mountain_mode(void) {
  s_mountain_requested = true;
  if (!s_esc_ready) {
    return;
  }

  esp_err_t ret = esc_set_ride_mode(ESC_RIDE_MODE_MOUNTAIN);
  if (ret != ESP_OK) {
    ESP_LOGW(TAG, "failed to enable Mountain mode: %s", esp_err_to_name(ret));
    return;
  }

  ret = display_blink_backlight();
  if (ret != ESP_OK) {
    ESP_LOGW(TAG, "failed to blink for Mountain mode: %s",
             esp_err_to_name(ret));
  }
}

static void nvs_init(void) {
  esp_err_t ret = nvs_flash_init();
  if (ret == ESP_ERR_NVS_NO_FREE_PAGES ||
      ret == ESP_ERR_NVS_NEW_VERSION_FOUND) {
    ESP_ERROR_CHECK(nvs_flash_erase());
    ret = nvs_flash_init();
  }
  ESP_ERROR_CHECK(ret);
}

static void peak_app_task(void *arg) {
  (void)arg;
  nvs_init();
  buttons_init();

  boot_mode_t boot_mode = boot(handle_boot_mountain_mode);
  ESP_ERROR_CHECK(display_start());
  ESP_ERROR_CHECK(display_adapter_start());

  esp_err_t esc_ret = esc_init();
  if (esc_ret != ESP_OK) {
    ESP_LOGE(TAG, "ESC initialization failed: %s", esp_err_to_name(esc_ret));
  } else {
    s_esc_ready = true;
    esp_err_t ret = esc_set_controller_enabled(true);
    if (ret != ESP_OK) {
      ESP_LOGW(TAG, "failed to enable controller: %s", esp_err_to_name(ret));
    }
    if (s_mountain_requested) {
      handle_boot_mountain_mode();
    }
  }

  i2c_master_init();
  ltr329_sensor_init(&bus_handle);
  t117_sensor_init(&bus_handle);

  battery_monitor_init();

  buttons_on(BTN_POWER, BTN_EVENT_LONG_PRESS_START, handle_button_power_long);
  buttons_on(BTN_POWER, BTN_EVENT_LONG_PRESS_END,
             handle_button_power_long_stop);
  buttons_on(BTN_UP, BTN_EVENT_CLICK, handle_gear_up);
  buttons_on(BTN_UP, BTN_EVENT_LONG_PRESS_START, handle_support_mode_toggle);
  buttons_on(BTN_DOWN, BTN_EVENT_CLICK, handle_gear_down);

  peak_ble_config_t ble_config = {
      .ota_enabled = boot_mode == BOOT_MODE_CONFIG,
  };
  esp_err_t ble_ret = peak_ble_start(&ble_config);
  if (ble_ret != ESP_OK) {
    ESP_LOGE(TAG, "BLE initialization failed: %s", esp_err_to_name(ble_ret));
  } else if (s_esc_ready) {
    esp_err_t bridge_ret = vesc_bridge_init();
    if (bridge_ret == ESP_OK) {
      const transport_iface_t *transports[] = {&transport_peak_ble};
      bridge_ret = vesc_bridge_start(transports, 1);
    }
    if (bridge_ret != ESP_OK) {
      ESP_LOGW(TAG, "VESC BLE bridge initialization failed: %s",
               esp_err_to_name(bridge_ret));
    }
  }

  for (;;) {
    vTaskDelay(pdMS_TO_TICKS(1000));
  }
}

void app_main(void) {
  BaseType_t ret = xTaskCreatePinnedToCoreWithCaps(
      peak_app_task, "peak_app", PEAK_APP_TASK_STACK_SIZE, NULL,
      ESP_TASK_MAIN_PRIO, NULL, ESP_TASK_MAIN_CORE,
      MALLOC_CAP_INTERNAL | MALLOC_CAP_8BIT | MALLOC_CAP_DMA);

  ESP_ERROR_CHECK(ret == pdPASS ? ESP_OK : ESP_ERR_NO_MEM);
}
