dkomeza/peak/(commit log)

2025-03-29 🔧 Add .gitignore
2025-03-29 ✨ Add hardware files
    [peak.kicad_pcb, peak.kicad_sch]
2025-03-29 📚 Fix typo
2025-04-22 ✨ Add initial software package
    [bottomStencil.scad, bottomStencil.stl, peak-EdgeCuts.dxf, peak-PasteBottom.dxf, peak-PasteTop.dxf, topStencil.scad, topStencil.stl]
2025-06-22 ✨ Initial software update
2025-06-22 🐛 Fix submodules
2025-06-24 ✨ Add BLE serial
2025-06-28 ✨ VESC interface updates
    [peak.3mf, peak.step]
2025-06-28 🐛 Separate VESC related functions into separate tasks, add RX and TX queue
2025-06-28 🔧 Try to debug firmware update
2025-11-09 ✨ Add schematic parts
    [connection.kicad_sch, mcu.kicad_sch, peak.kicad_sch, power_supply.kicad_sch]
2025-11-10 ✨ Further power supply schematic
    [mcu.kicad_sch, power_supply.kicad_sch]
2025-11-10 ✨ Add pulldown to disable the led by default
    [peak.kicad_sch, power_supply.kicad_sch]
2025-11-13 ✨ Further schematic updates
    [connection.kicad_sch, display.kicad_sch, io.kicad_sch, mcu.kicad_sch, peak.kicad_pcb, peak.kicad_sch, power_supply.kicad_sch]
2025-11-14 ✨ MCU updates
    [mcu.kicad_sch, peak.kicad_sch, wireless.kicad_sch]
2025-11-14 ✨ Done wireless schematic
    [mcu.kicad_sch, peak.kicad_sch, wireless.kicad_sch]
2025-12-02 📂 PCB updates
    [connection.kicad_sch, display.kicad_sch, io.kicad_sch, mcu.kicad_sch, peak.kicad_pcb, peak.kicad_sch, power_supply.kicad_sch, wireless.kicad_sch]
2025-12-08 🐛 Fix errors from rev1.0
    [connection.kicad_sch, display.kicad_sch, io.kicad_sch, mcu.kicad_sch, peak.kicad_pcb, peak.kicad_sch, power_supply.kicad_sch, wireless.kicad_sch]
2025-12-08 ✨ Finish rev 1.1
    [mcu.kicad_sch, peak.kicad_pcb]
2026-01-10 🔨 Update the pcb
    [peak.kicad_pcb]
2026-01-13 🔥 Redo the PCB
    [connection.kicad_sch, peak.kicad_pcb, power_supply.kicad_sch]
2026-01-26 ✨ Final PCB updates
    [connection.kicad_sch, display.kicad_sch, io.kicad_sch, mcu.kicad_sch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]
2026-03-02 ✨ Final PCB v.1 updates
    [peak.kicad_pcb, power_supply.kicad_sch]
2026-03-31 ✨ Update the bom
2026-04-02 🔥 Use new PCB
2026-04-02 🔥 Remove old dependencies
2026-04-02 ✨ Add T117 support
2026-04-04 ✨ Make buttons work
2026-04-27 🔥 Cleanup
2026-04-28 ✨ Add mountain mode callback to the boot sequence (#2)
2026-05-02 docs: add VESC UDP bridge rewrite spec
    Document the approved full rewrite design for the VESC bridge. The spec fixes UDP port 65102, preserves VESC packet framing, defines the one-client UDP peer model, and records that tests are out of scope for this rewrite.
2026-05-02 ✨ Make VESC UDP-CAN bridge work
2026-05-03 ✨ Add BLE bridge
2026-05-03 🔨 Split the code into separate components
2026-05-05 ✨ Add input voltage sensing
2026-05-08 🐛 Fix BLE
2026-05-09 ✨ Add basic UART support
2026-05-09 ✨ Soft AP support
2026-05-09 ✨ OTA support
2026-05-11 ✨ Add kt data
2026-05-11 ✨ Create get kt data function
2026-05-11 ✨ Complete kt protocol
2026-05-11 🐛 Fix errors
2026-05-12 ✨ Add peak esc support
2026-05-23 docs: add loom graphics design
    Document the planned loom immediate-mode graphics component for the ESP32-P4 display stack.
    The design covers tiled RGB888 rendering, command recording, partial-buffer ownership, ESP32-P4 accelerator usage, text/font handling, and initial validation expectations. It keeps the existing display initialization outside loom so implementation can proceed without disturbing current panel bring-up work.
2026-05-23 fix: allow clipped loom commands
    Record valid Loom commands even when their bounds are fully outside the active clip or screen. Empty clipped bounds no longer set the frame sticky error; only visible bounds update the dirty region, while capacity overflow remains the sticky no-memory path.
2026-05-23 fix: harden loom command recording
    Add 8-bit heap capabilities to Loom allocations and guard tile size calculations against overflow. Harden command bounds math with int64_t-based saturation, validate bitmap formats and strides, and copy text command strings into frame-owned internal memory that is released on frame reset, destroy, or end_frame completion.
2026-05-23 fix: add loom ESP32-P4 flush
    Implement the ESP32-P4 loom backend flush entry point so rendered tiles are forwarded to the configured esp_lcd panel handle. The function validates the loom, tile buffer, panel handle, and tile rectangle before delegating to esp_lcd_panel_draw_bitmap.
2026-05-23 fix: flush full-width loom tiles
    Render and flush dirty frames as full-width vertical tiles so the ESP LCD backend receives tightly packed RGB888 rectangle data. The dirty region still bounds the vertical tile range, preserving partial buffering by height while avoiding unsafe horizontal dirty rectangles with the current stride layout.
2026-05-23 fix: wait for loom DPI flushes
    Register the MIPI DPI color-transfer callback when loom is created and use a binary semaphore to wait for each DMA2D-backed bitmap transfer before reusing tile buffers. The semaphore is cleaned up with the rest of the loom allocations.
    Also check the display initialization result in the main app task so display setup failures are surfaced through ESP_ERROR_CHECK.
    [main.c]
2026-05-23 feat: draw display demo with loom
    Wire the loom renderer into the existing display initialization path and replace the direct pixel test with a tiled RGB888 smoke demo.
    The ESP32-P4 backend now documents DPI callback ownership and clears callbacks on destroy so DMA2D-backed panel transfers cannot outlive loom-owned tile buffers.
    [display.c, display.h]
2026-05-23 feat: log loom frame timing
    Add debug timing around tiled loom frame rendering with command count and elapsed microseconds.
    The loom component now declares its private esp_timer dependency so timing diagnostics build independently of the app component.
2026-05-24 perf: optimize loom rendering
    Pipeline tile flushes across the two loom buffers so CPU rasterization can overlap with the LCD DMA transfer. Add faster RGB888 fill paths, PPA-backed solid fills, and generated font assets used by the loom renderer.
2026-05-24 feat: wire display demo dependencies
    Use the ST7701 component dependency from the main manifest, record the resolved lockfile and sdkconfig updates, and run the loom display demo as a persistent task with text rendering. Update the hosted submodule pointer to the matching slave configuration commit.
    [display.c]
2026-05-24 docs: add agent guidance
    Document the repo scope, ESP32-P4 and ESP32-C6 ESP-Hosted hardware split, embedded firmware priorities, and the project preference for beneficial refactors. This gives future agents a clear operating guide before changing the codebase.
2026-05-24 feat: add ESC controller commands
    Add a shared ESC controller interface and wire PEAK and KT implementations through it. Document the CycleIQ CAN protocol and add command helpers for power, gear, support mode, and ride mode handling.
2026-05-24 feat: wire controls into display UI
    Connect button events to ESC controller commands and display feedback. Add larger Loom font assets and render live PEAK telemetry values for speed, gear, support mode, battery, temperature, and power on the display.
2026-05-24 🐛 Correct CAN ID naming
2026-05-26 refactor: use CycleIQ SDK for Peak ESC
    Add the CycleIQ protocol SDK as an ESP-IDF submodule and wire the ESC component to its public frame helpers. Peak ESC commands now build SDK frames before sending them over the existing CAN transport.
    Replace local protocol constants with SDK packet IDs, lengths, and version helpers while preserving the existing display telemetry snapshot. The obsolete in-repo protocol headers are removed so the SDK owns the shared wire definitions.
2026-05-26 chore: update CycleIQ SDK
    Bump the nested cycleiq_protocol SDK checkout to the latest upstream commit so the firmware builds against protocol 1.2.0 helpers.
    Recognize the new config telemetry packet IDs in the PEAK ESC parser and intentionally ignore them until ESC settings support is implemented in the display firmware.
2026-05-31 feat: extract loom submodule
    Replace the in-tree loom component with the standalone loom repository and point the superproject at the new clean root commit.
    Update the Peak display path to create loom through the ESP-IDF adapter so the public loom API can stay platform-neutral while preserving the existing RGB888 tiled renderer and panel flush behavior.
    [display.c]
2026-05-31 🔨 Move loom to separate repo
2026-06-28 fix: swap button pins for loom update
    [buttons.c]
2026-06-28 refactor: support multiple VESC transports
2026-08-11 🔨 Switch can.c to esp-idf 6.0
2026-08-11 🔨 Migrate display.c to esp-idf 6.0
2026-08-22 feat: add LVGL display baseline
    Replace the custom display renderer with the initial LVGL display port\nand component-based UI baseline.\n\nAdd LVGL and the supporting display, configuration, and asset-partition\nchanges needed to bring up the new rendering path.
    [partitions.csv]
2026-08-22 refactor: isolate display runtime
    Move display ownership into a dedicated LVGL task and add a typed,\nbounded event boundary for application updates.\n\nThe application no longer calls LVGL or depends on display internals, and\nthe unused experimental grid and card renderer is removed from the build.
    [display.c, display.h, home.c, home.h, main.c]
2026-08-22 refactor: move board display port
    Make the display component own the MIPI panel port instead of\ncompiling board display code through the application component.
2026-08-22 refactor: simplify display port setup
    Separate the ST7701 initialization sequence from panel setup and keep\nthe RGB888 LVGL port in short, focused functions.\n\nRefresh the managed dependency lock after moving the display component and\nverify the firmware builds for ESP32-P4.
    [display.c, display_port.c]
2026-08-22 feat: publish decoded ESC display events
    Expose one boot-time observer for decoded PEAK telemetry and map each\nvalid packet group to a non-blocking display event in the application.\n\nThis keeps the ESC and LVGL components independent while allowing the UI\ntask to receive live telemetry without polling snapshots.
2026-08-22 feat: add event-driven home dashboard
    Render the initial home screen from a private UI model updated by typed\ndisplay events.\n\nKeep visual primitives small and static while live ESC data fills speed,\npower, battery, assist, and mode metrics without LVGL leaking into the\napplication or ESC components.
    [display.c, home.c, home.h]
2026-08-22 feat: wire CycleIQ boot commands
    Activate the existing boot selector and defer its Mountain callback into
    the application queue. This keeps button-timing policy in the authoritative
    boot module while ensuring CycleIQ commands only run after CAN and the
    controller interface are initialized.
2026-08-23 fix: make Power button control CycleIQ
    Replace the legacy long-Power ride-mode toggle with explicit CycleIQ
    power-on and power-off requests. Track only commands accepted by the local
    CAN driver and stop walk mode before requesting controller shutdown.
    [main.c]
2026-08-23 fix: retain queued CAN frames
    Copy outgoing frames into a fixed CAN-owned pool until the TWAI driver
    reports transmission complete. Also correct the FreeRTOS queue success check
    so the dispatcher delivers received controller frames.
    [can.c]
2026-08-23 feat: deep sleep after CycleIQ shutdown
    Run controller shutdown on long-Power release, wait for queued CAN
    transmission, and put the panel to sleep through the display task. Enter
    ESP32-P4 deep sleep with GPIO7 active-low wake, while ignoring the release
    that completes a normal boot hold.
2026-09-02 refactor: simplify startup button handling
    Adopt the new boot-button sequence and make the button state\nmachine discard the initial power press until release.\n\nThis prevents the boot hold from being interpreted as a runtime shutdown\ngesture while retaining the asynchronous mountain-mode selection.
    [button.c, buttons.c, buttons.h, main.c]
2026-09-02 refactor: unify ESC backends
    Select KT or CycleIQ at build time behind one small ESC interface.\nNormalize telemetry for the display while retaining KT-owned controls\nand CycleIQ controller-owned state.
2026-09-06 refactor: stream OTA images safely
    Replace the HTTP-specific OTA manager with a bounded streaming
    session. The new API validates offsets, image size, and SHA-256 before
    selecting the inactive application partition for the next boot.
    Transport code can now feed firmware bytes without coupling OTA to
    Wi-Fi, JSON status, task ownership, or reboot policy.
2026-09-06 feat: add direct BLE OTA client
    Replace the BLE-triggered HTTP workflow with a versioned binary transfer
    client. The uploader hashes local firmware, streams sequential writes,
    and reports the device state through fixed-size status packets.
    Document the shared protocol, architecture boundaries, authorization
    policy, future hardening, and hardware verification matrix. Add protocol
    unit tests that run without a BLE adapter or Bleak installation.
2026-09-06 feat: add unified BLE runtime
    Replace the separate BLE manager, VESC bridge, and HTTP-triggered OTA\npath with one ESP-Hosted NimBLE component. It owns NUS compatibility,\ndirect OTA GATT services, bounded worker queues, and connection lifecycle.\n\nWire the runtime into boot mode so OTA is authorized only during the\nphysical configuration window, trim unused NimBLE roles/services, and\nremove the obsolete BLE implementation. Extend the uploader's stable\nstatus error handling and document the direct BLE workflow.
    [main.c]
2026-09-06 fix: harden NimBLE runtime configuration
    Derive the advertised device name from the hosted controller's
    Bluetooth MAC address and clean up every partial ESP-Hosted startup
    state so BLE can be retried safely.
    Constrain NimBLE to the features used by the peripheral GATT server,
    removing unused security, privacy, test, prepared-write, and dynamic
    allocation paths for a predictable embedded runtime.
2026-09-07 feat: add MVP ride display
    Replace the generic display event pipeline and metric-card dashboard with a
    latest-state mailbox and a focused LVGL home screen. The display now shows
    current speed, battery voltage, and a five-step gear indicator while keeping
    all LVGL and backlight work on the display task.
    Remove obsolete event, model, and metric-card layers, and enable the 48px
    Montserrat font for the primary speed reading.
    [display.c, display.h, display_adapter.c, home.c, home.h, main.c]
2026-09-07 feat: show support mode
    Render the current PAS or torque mode above the speed readout.
    Map the value explicitly at the ESC/display boundary.
    Keep unsupported values in the existing unknown state.
    Reshape the gear indicators into wider, shorter rounded bars.
    [display.h, display_adapter.c, home.c, home.h]
2026-09-07 feat: blink for Mountain mode
    Blink the backlight on entry to a confirmed Mountain ride mode.
    Queue the effect to the display task so ESC callbacks remain non-blocking.
2026-09-07 fix: preserve CAN RX payload buffer
    Receive queued CAN frames into the concrete queue item type rather than\na TWAI frame descriptor. This preserves the inline payload bytes and avoids\ntreating them as a pointer when dispatching received frames.
    [can.c]
2026-10-01 feat: show ESC temperatures
    Forward motor and controller thermal telemetry to the display and render\nlabelled readings with an unavailable-state placeholder.
2026-10-01 feat: highlight thermal readings
    Move motor and controller temperatures to large bottom status cells and\napply escalating color and critical-temperature pulse alerts.
2026-10-01 feat: add controller power control
    Advance the CycleIQ protocol and expose controller enable state through\nthe shared ESC interface. Enable the controller at startup and request\ndisabling it before Peak enters deep sleep.
2026-10-01 feat: toggle support mode from button
    Use the Up-button long press to switch between PAS and Torque\nmodes after confirmed ESC state is available.
2026-10-01 feat: add display gauge prototype
    Add an interactive browser prototype for the Peak gauge and gear-bar\ndisplay design.
